robmacl/ilemt_cal_hw/stage/Pics/driver_label.jpg

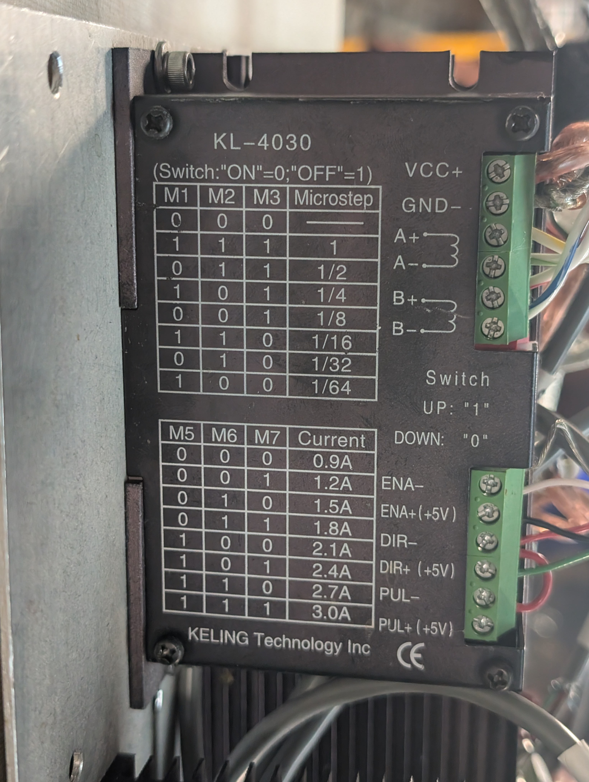
stage/Pics/driver_label.jpg
