robmacl/ilemt_cal_hw/stage/Pics/driver_switch_settings.jpg

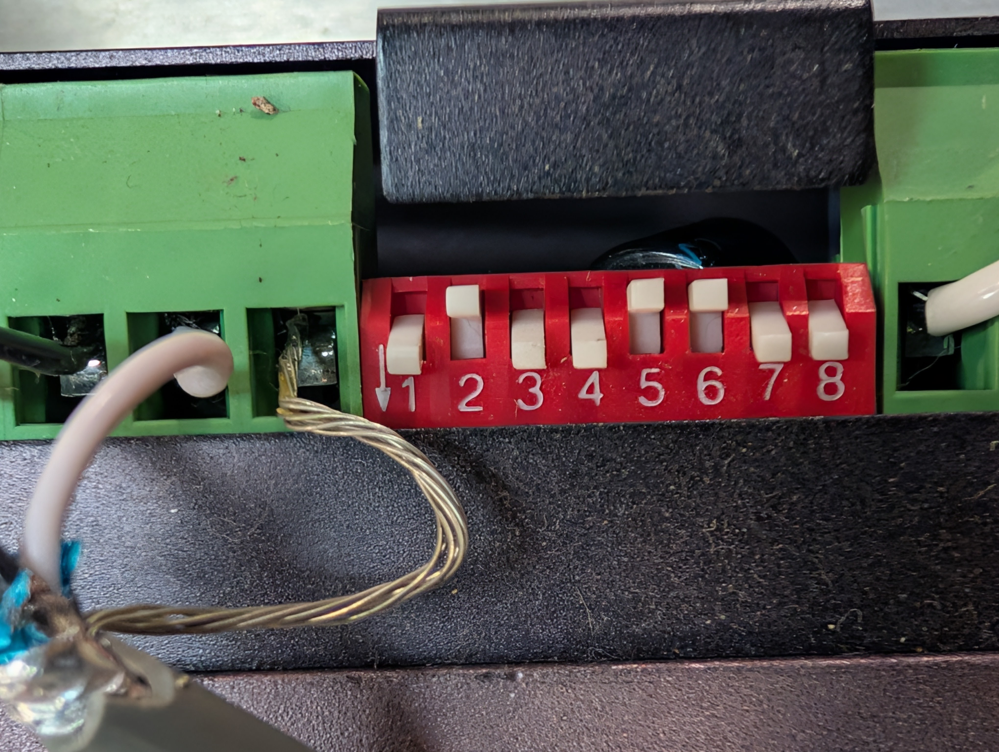
stage/Pics/driver_switch_settings.jpg
