robmacl/ilemt_cal_hw/stage/Pics/MC508_cable_id.jpg

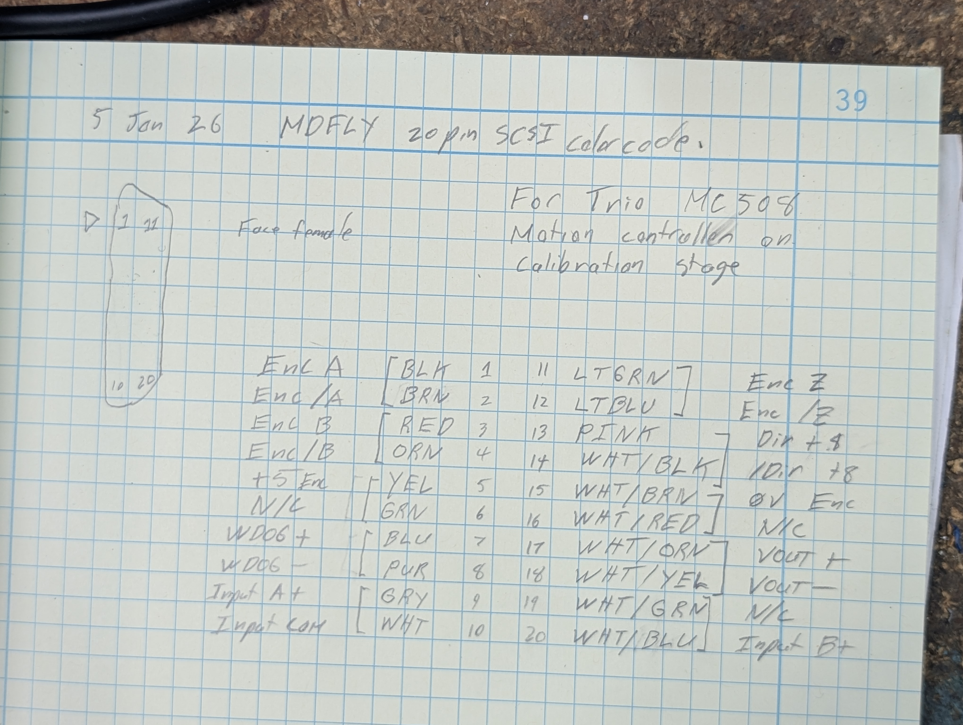
stage/Pics/MC508_cable_id.jpg
