robmacl/ilemt_cal_hw/stage/Pics/NI_UMI-77774_connector_side.jpg

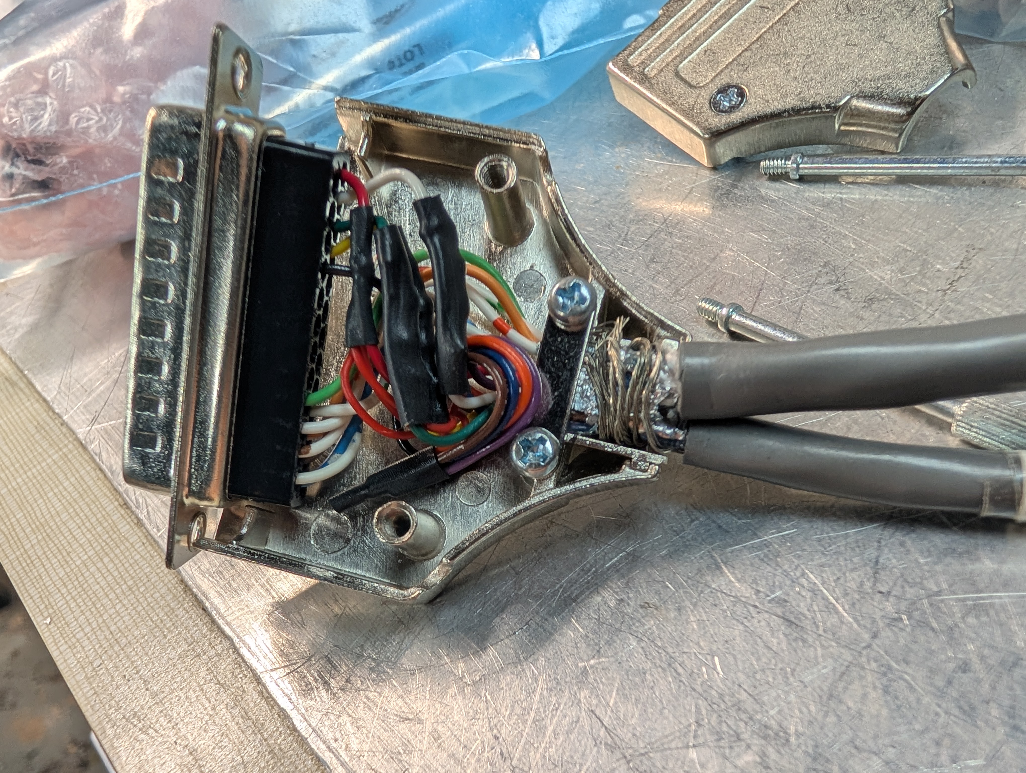
stage/Pics/NI_UMI-77774_connector_side.jpg
