robmacl/ilemt_cal_hw/stage/TrioDocumentation/MotionPerfect/AlarmSupport_files/image004.png

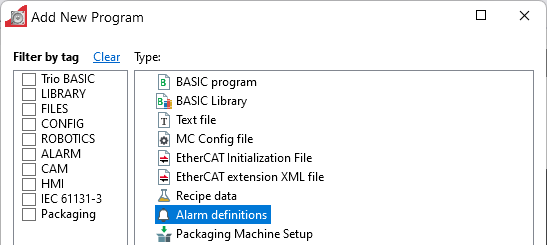
stage/TrioDocumentation/MotionPerfect/AlarmSupport_files/image004.png
