robmacl/ilemt_cal_hw/stage/TrioDocumentation/MotionPerfect/AlarmSupport_files/image006.png

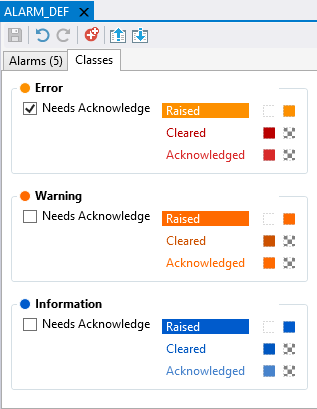
stage/TrioDocumentation/MotionPerfect/AlarmSupport_files/image006.png
