robmacl/ilemt_cal_hw/stage/TrioDocumentation/MotionPerfect/AnalogueIOViewer_files/image003.png

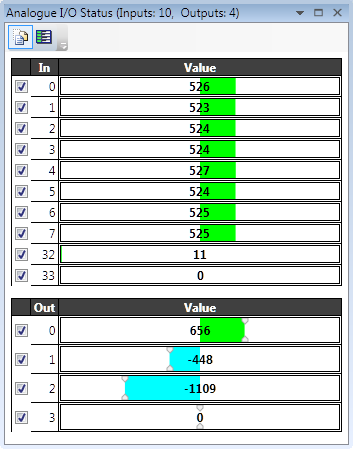
stage/TrioDocumentation/MotionPerfect/AnalogueIOViewer_files/image003.png
