robmacl/ilemt_cal_hw/stage/TrioDocumentation/MotionPerfect/APISymbols_files/image002.png

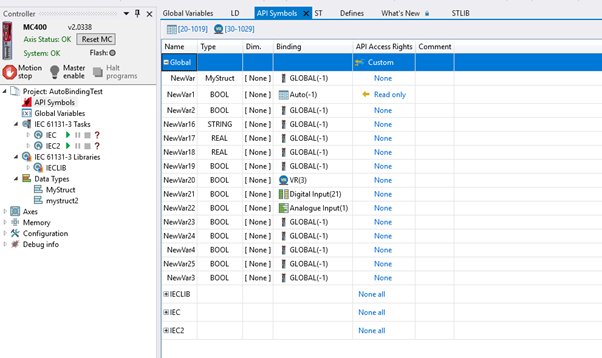
stage/TrioDocumentation/MotionPerfect/APISymbols_files/image002.png
