robmacl/ilemt_cal_hw/stage/TrioDocumentation/MotionPerfect/AutoBindings_files/image004.png

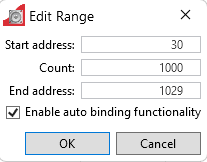
stage/TrioDocumentation/MotionPerfect/AutoBindings_files/image004.png
