robmacl/ilemt_cal_hw/stage/TrioDocumentation/MotionPerfect/AxisParameters_files/image009.jpg

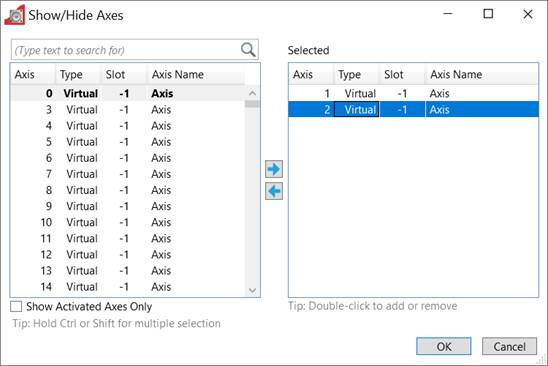
stage/TrioDocumentation/MotionPerfect/AxisParameters_files/image009.jpg
