robmacl/ilemt_cal_hw/stage/TrioDocumentation/MotionPerfect/ConnectionDialog_files/image008.png

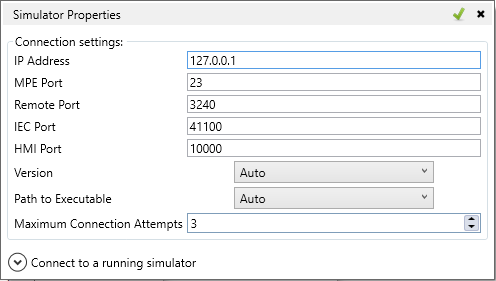
stage/TrioDocumentation/MotionPerfect/ConnectionDialog_files/image008.png
