robmacl/ilemt_cal_hw/stage/TrioDocumentation/MotionPerfect/DateAndTime_files/image002.png

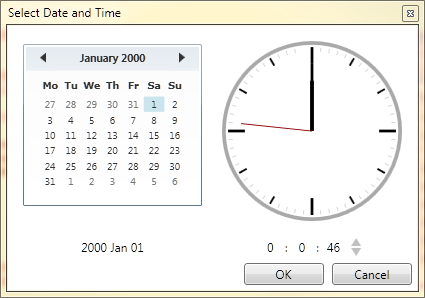
stage/TrioDocumentation/MotionPerfect/DateAndTime_files/image002.png
