robmacl/ilemt_cal_hw/stage/TrioDocumentation/MotionPerfect/DigitalIOViewer_files/image001.png

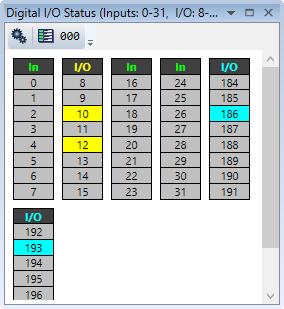
stage/TrioDocumentation/MotionPerfect/DigitalIOViewer_files/image001.png
