robmacl/ilemt_cal_hw/stage/TrioDocumentation/MotionPerfect/DigitalIOViewer_files/image004.png

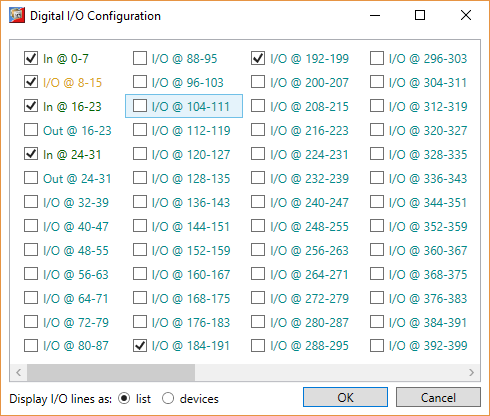
stage/TrioDocumentation/MotionPerfect/DigitalIOViewer_files/image004.png
