robmacl/ilemt_cal_hw/stage/TrioDocumentation/MotionPerfect/EtherCAT-Device-CoEObjects_files/image004.png

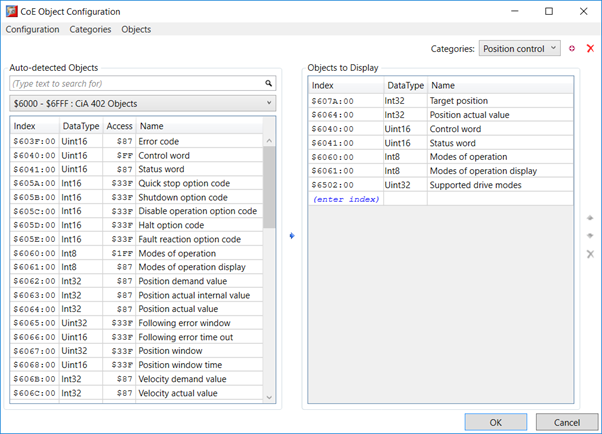
stage/TrioDocumentation/MotionPerfect/EtherCAT-Device-CoEObjects_files/image004.png
