robmacl/ilemt_cal_hw/stage/TrioDocumentation/MotionPerfect/EtherCAT-Device-FirmwareUpgrade_files/image003.png

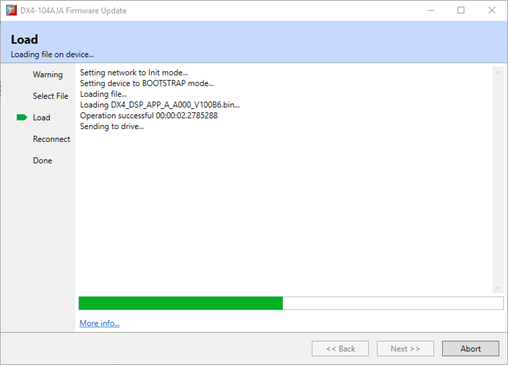
stage/TrioDocumentation/MotionPerfect/EtherCAT-Device-FirmwareUpgrade_files/image003.png
