robmacl/ilemt_cal_hw/stage/TrioDocumentation/MotionPerfect/EtherCAT-Device-Info_files/image001.png

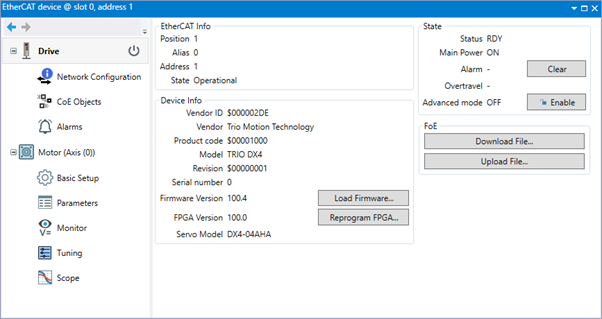
stage/TrioDocumentation/MotionPerfect/EtherCAT-Device-Info_files/image001.png
