robmacl/ilemt_cal_hw/stage/TrioDocumentation/MotionPerfect/EtherCAT-Diagnostics_files/image006.jpg

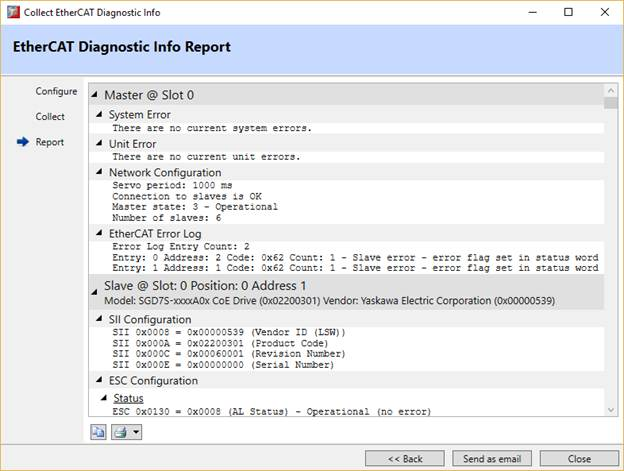
stage/TrioDocumentation/MotionPerfect/EtherCAT-Diagnostics_files/image006.jpg
