robmacl/ilemt_cal_hw/stage/TrioDocumentation/MotionPerfect/EtherCAT-Drive-Jog_files/image005.png

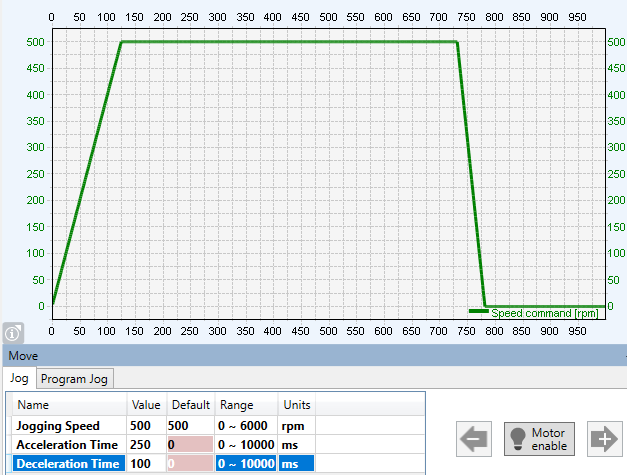
stage/TrioDocumentation/MotionPerfect/EtherCAT-Drive-Jog_files/image005.png
