robmacl/ilemt_cal_hw/stage/TrioDocumentation/MotionPerfect/EtherCAT-Drive-Parameters_files/image014.png

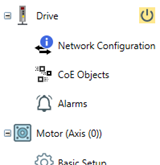
stage/TrioDocumentation/MotionPerfect/EtherCAT-Drive-Parameters_files/image014.png
