robmacl/ilemt_cal_hw/stage/TrioDocumentation/MotionPerfect/EtherCAT-Drive-Scope_files/image011.png

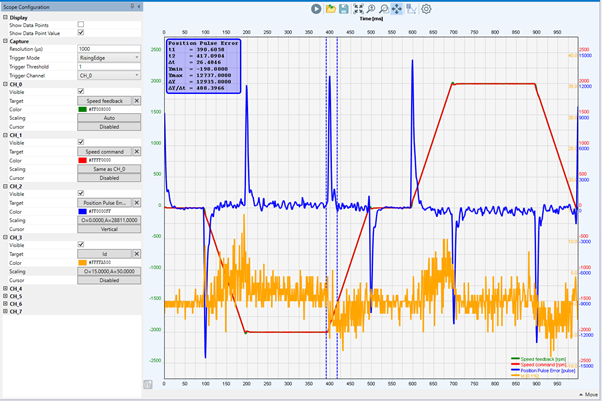
stage/TrioDocumentation/MotionPerfect/EtherCAT-Drive-Scope_files/image011.png
