robmacl/ilemt_cal_hw/stage/TrioDocumentation/MotionPerfect/EtherCAT-EC_EXTEND-Editor_files/image046.png

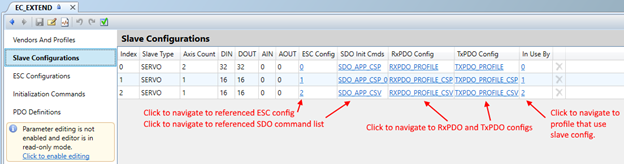
stage/TrioDocumentation/MotionPerfect/EtherCAT-EC_EXTEND-Editor_files/image046.png
