robmacl/ilemt_cal_hw/stage/TrioDocumentation/MotionPerfect/EtherCAT-ESI-Import_files/image011.jpg

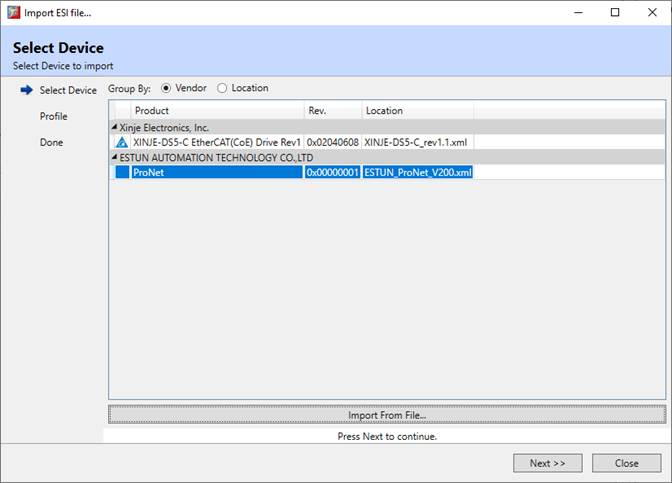
stage/TrioDocumentation/MotionPerfect/EtherCAT-ESI-Import_files/image011.jpg
