robmacl/ilemt_cal_hw/stage/TrioDocumentation/MotionPerfect/EtherCAT-ESI-Import_files/image020.jpg

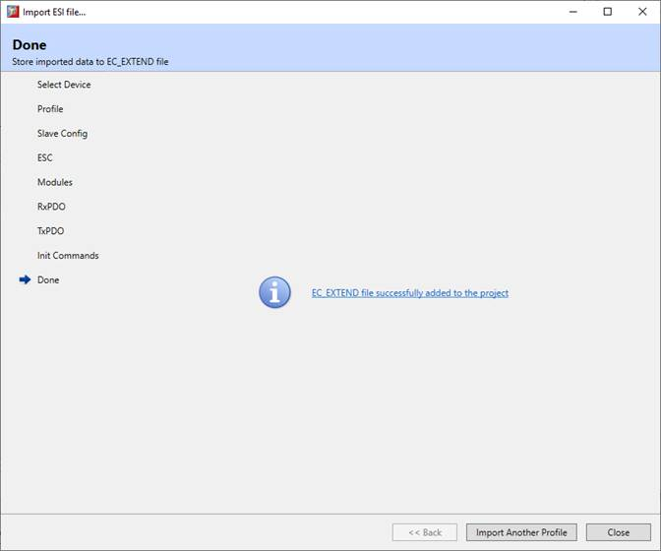
stage/TrioDocumentation/MotionPerfect/EtherCAT-ESI-Import_files/image020.jpg
