robmacl/ilemt_cal_hw/stage/TrioDocumentation/MotionPerfect/GlobalVariables_files/image001.png

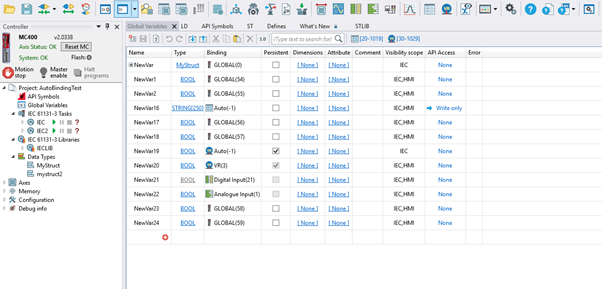
stage/TrioDocumentation/MotionPerfect/GlobalVariables_files/image001.png
