robmacl/ilemt_cal_hw/stage/TrioDocumentation/MotionPerfect/GoTo_files/image001.png

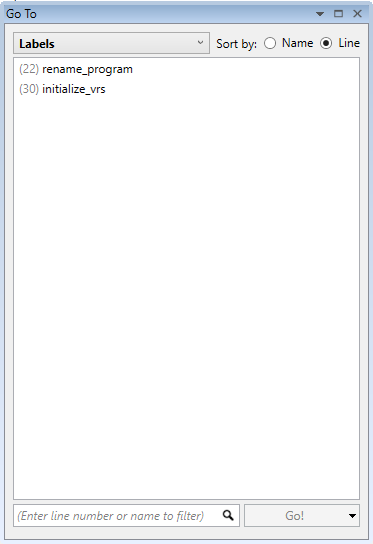
stage/TrioDocumentation/MotionPerfect/GoTo_files/image001.png
