robmacl/ilemt_cal_hw/stage/TrioDocumentation/MotionPerfect/ImportExportValues_files/image001.png

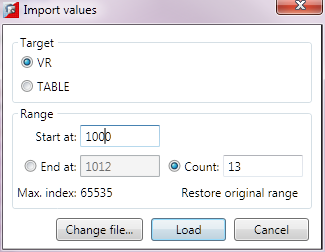
stage/TrioDocumentation/MotionPerfect/ImportExportValues_files/image001.png
