robmacl/ilemt_cal_hw/stage/TrioDocumentation/MotionPerfect/ImportExportValues_files/image002.png

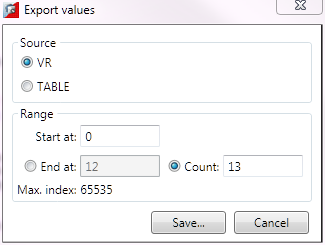
stage/TrioDocumentation/MotionPerfect/ImportExportValues_files/image002.png
