robmacl/ilemt_cal_hw/stage/TrioDocumentation/MotionPerfect/InitialConnection_files/image003.png

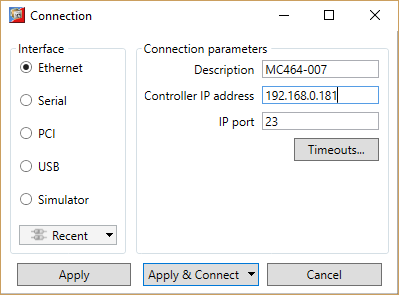
stage/TrioDocumentation/MotionPerfect/InitialConnection_files/image003.png
