robmacl/ilemt_cal_hw/stage/TrioDocumentation/MotionPerfect/LoadSystem_files/image005.png

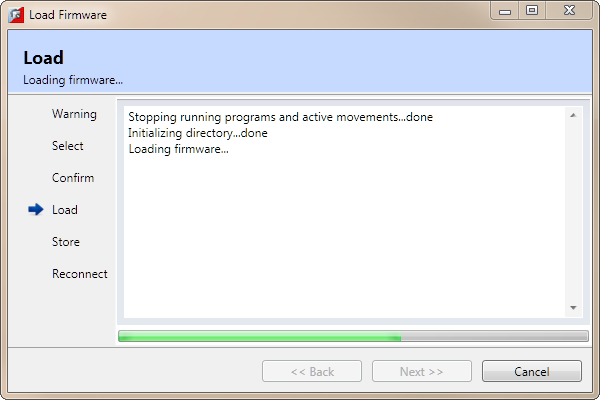
stage/TrioDocumentation/MotionPerfect/LoadSystem_files/image005.png
