robmacl/ilemt_cal_hw/stage/TrioDocumentation/MotionPerfect/LoadSystem_files/image006.png

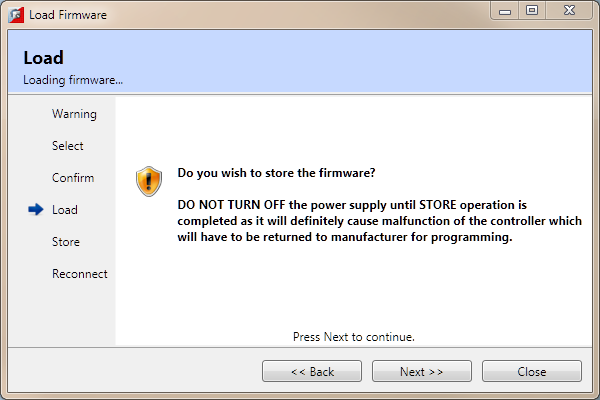
stage/TrioDocumentation/MotionPerfect/LoadSystem_files/image006.png
