robmacl/ilemt_cal_hw/stage/TrioDocumentation/MotionPerfect/MainWindow_files/image003.jpg

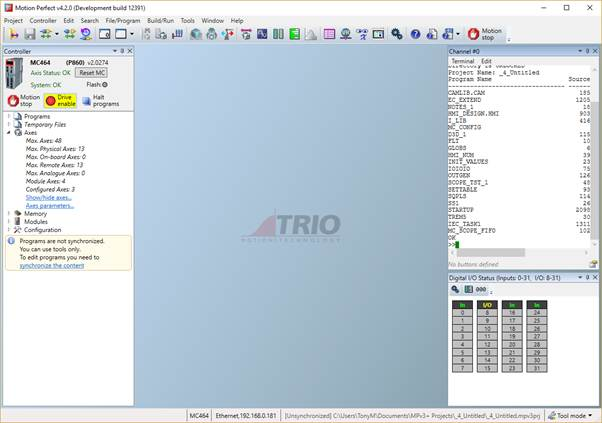
stage/TrioDocumentation/MotionPerfect/MainWindow_files/image003.jpg
