robmacl/ilemt_cal_hw/stage/TrioDocumentation/MotionPerfect/MemoryCardManager_files/image002.png

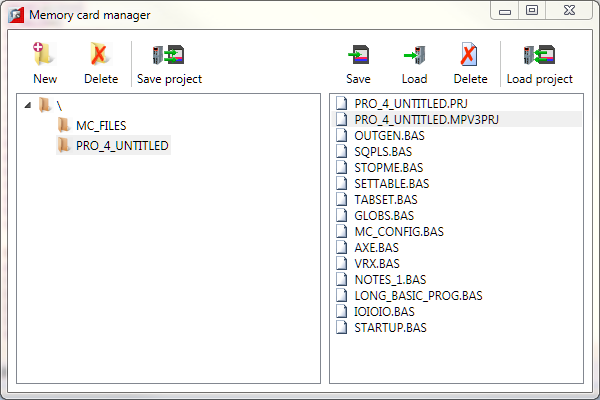
stage/TrioDocumentation/MotionPerfect/MemoryCardManager_files/image002.png
