robmacl/ilemt_cal_hw/stage/TrioDocumentation/MotionPerfect/ModifySTARTUP_files/image009.png

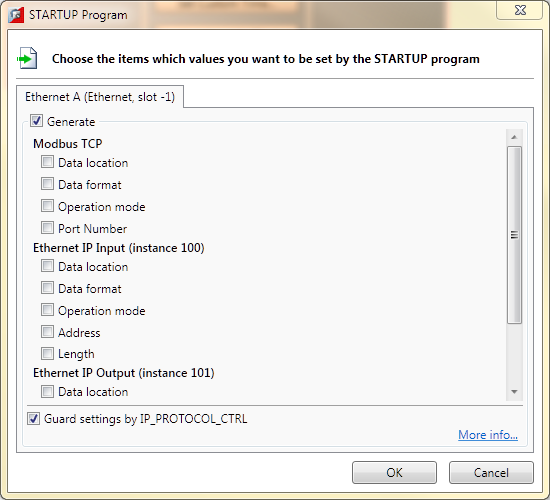
stage/TrioDocumentation/MotionPerfect/ModifySTARTUP_files/image009.png
