robmacl/ilemt_cal_hw/stage/TrioDocumentation/MotionPerfect/Options_Diagnostics_files/image001.jpg

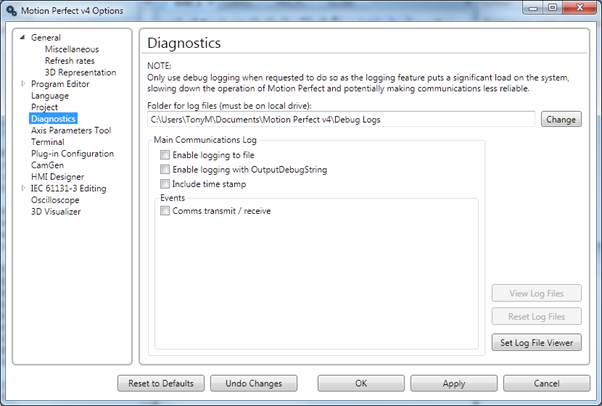
stage/TrioDocumentation/MotionPerfect/Options_Diagnostics_files/image001.jpg
