robmacl/ilemt_cal_hw/stage/TrioDocumentation/MotionPerfect/Options_HMI_Designer-FontsAndColours_files/image001.jpg

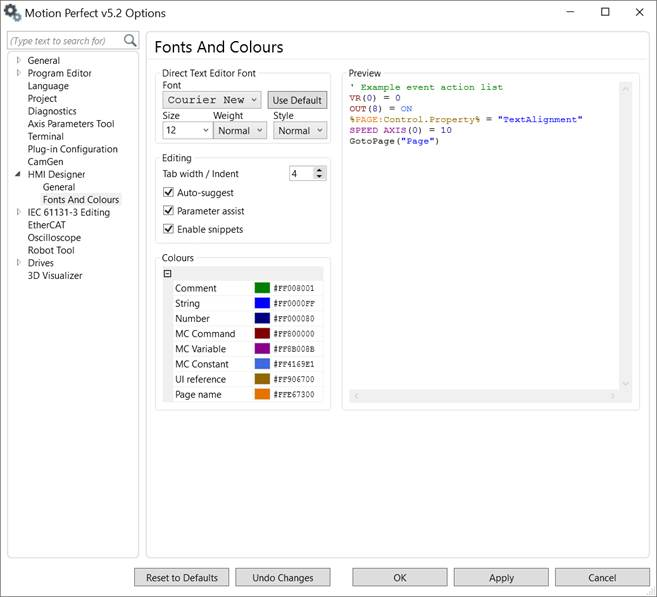
stage/TrioDocumentation/MotionPerfect/Options_HMI_Designer-FontsAndColours_files/image001.jpg
