robmacl/ilemt_cal_hw/stage/TrioDocumentation/MotionPerfect/Options_IEC61131-General_files/image001.jpg

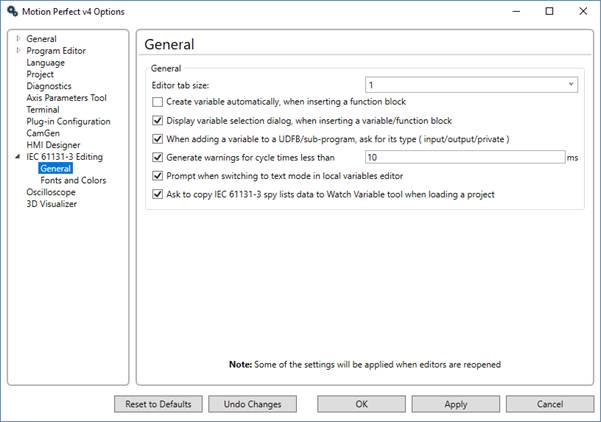
stage/TrioDocumentation/MotionPerfect/Options_IEC61131-General_files/image001.jpg
