robmacl/ilemt_cal_hw/stage/TrioDocumentation/MotionPerfect/Options_Oscilloscope_files/image002.png

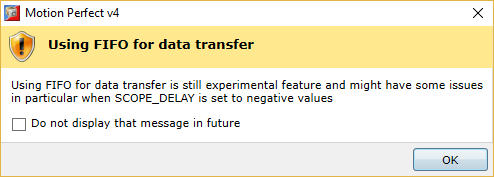
stage/TrioDocumentation/MotionPerfect/Options_Oscilloscope_files/image002.png
