robmacl/ilemt_cal_hw/stage/TrioDocumentation/MotionPerfect/Oscilloscope_files/image001.png

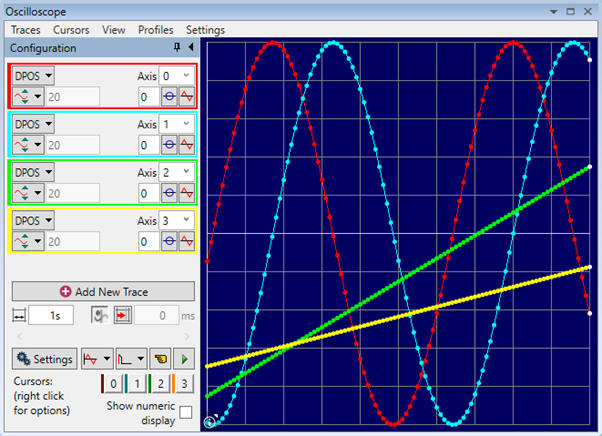
stage/TrioDocumentation/MotionPerfect/Oscilloscope_files/image001.png
