robmacl/ilemt_cal_hw/stage/TrioDocumentation/MotionPerfect/Oscilloscope_HorizontalControls_files/image027.png

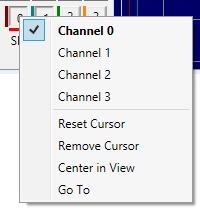
stage/TrioDocumentation/MotionPerfect/Oscilloscope_HorizontalControls_files/image027.png
