robmacl/ilemt_cal_hw/stage/TrioDocumentation/MotionPerfect/Oscilloscope_Settings_files/image003.jpg

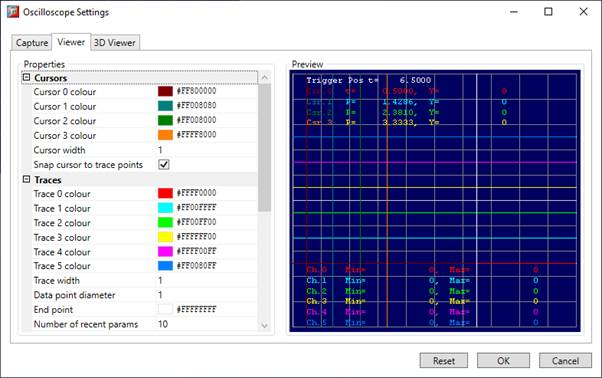
stage/TrioDocumentation/MotionPerfect/Oscilloscope_Settings_files/image003.jpg
