robmacl/ilemt_cal_hw/stage/TrioDocumentation/MotionPerfect/Oscilloscope_ViewModes_files/image004.png

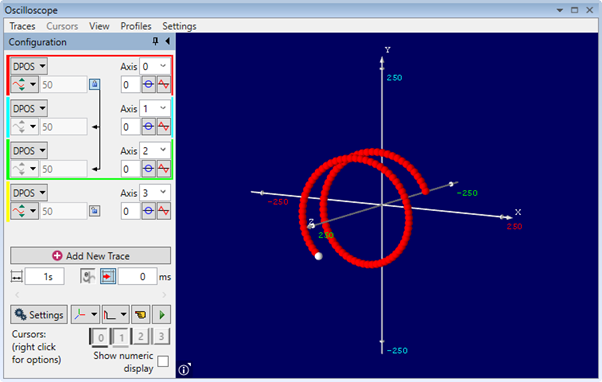
stage/TrioDocumentation/MotionPerfect/Oscilloscope_ViewModes_files/image004.png
