robmacl/ilemt_cal_hw/stage/TrioDocumentation/MotionPerfect/Package_AuthoringExample_files/image004.jpg

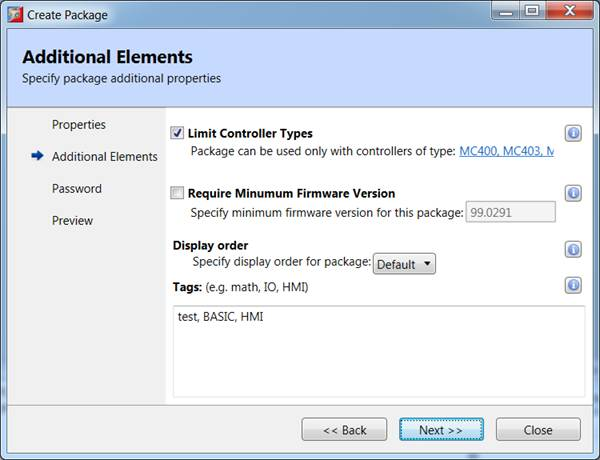
stage/TrioDocumentation/MotionPerfect/Package_AuthoringExample_files/image004.jpg
