robmacl/ilemt_cal_hw/stage/TrioDocumentation/MotionPerfect/Package_AuthoringExample_files/image005.jpg

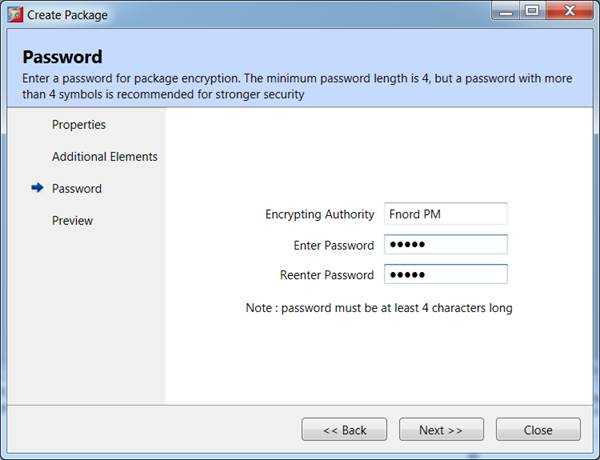
stage/TrioDocumentation/MotionPerfect/Package_AuthoringExample_files/image005.jpg
