robmacl/ilemt_cal_hw/stage/TrioDocumentation/MotionPerfect/Package_Update_files/image004.png

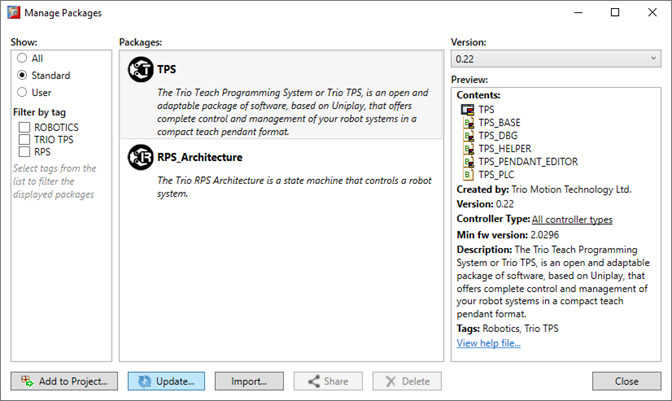
stage/TrioDocumentation/MotionPerfect/Package_Update_files/image004.png
