robmacl/ilemt_cal_hw/stage/TrioDocumentation/MotionPerfect/ProjectCheck_files/image010.png

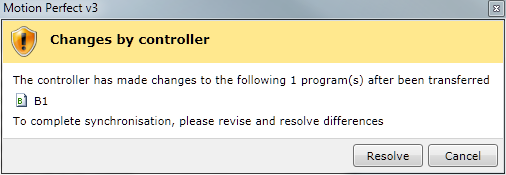
stage/TrioDocumentation/MotionPerfect/ProjectCheck_files/image010.png
