robmacl/ilemt_cal_hw/stage/TrioDocumentation/MotionPerfect/ProjectEncryption-EncryptProject_files/image001.jpg

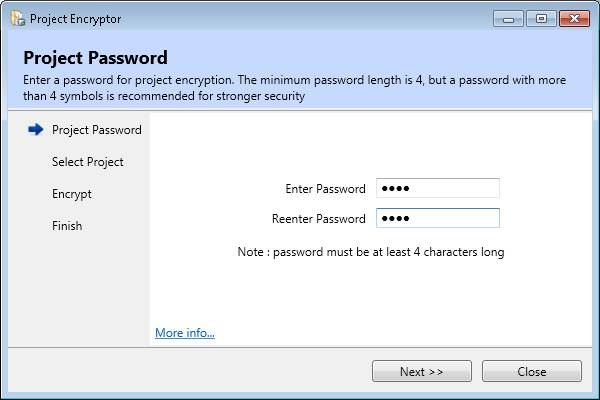
stage/TrioDocumentation/MotionPerfect/ProjectEncryption-EncryptProject_files/image001.jpg
