robmacl/ilemt_cal_hw/stage/TrioDocumentation/MotionPerfect/ProjectItemGroups_files/image002.png

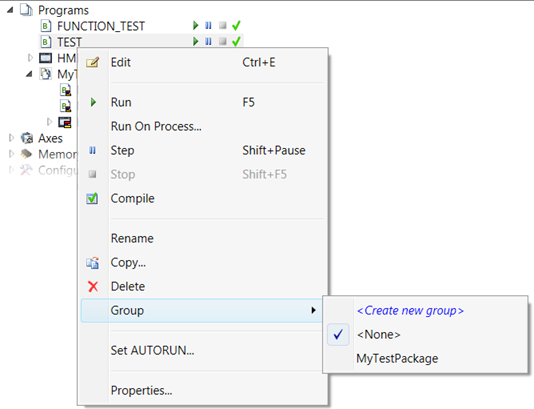
stage/TrioDocumentation/MotionPerfect/ProjectItemGroups_files/image002.png
