robmacl/ilemt_cal_hw/stage/TrioDocumentation/MotionPerfect/ProjectTemplate_Creation_files/image003.jpg

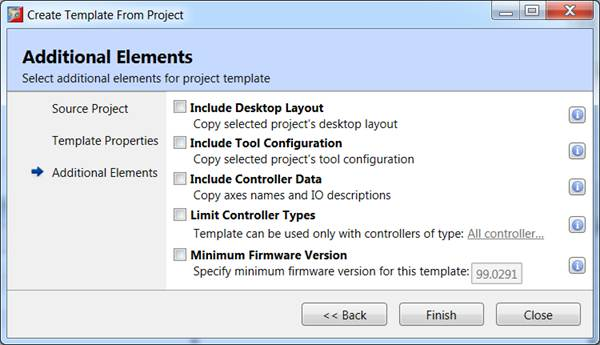
stage/TrioDocumentation/MotionPerfect/ProjectTemplate_Creation_files/image003.jpg
