robmacl/ilemt_cal_hw/stage/TrioDocumentation/MotionPerfect/ProjectTemplate_Updates_files/image002.png

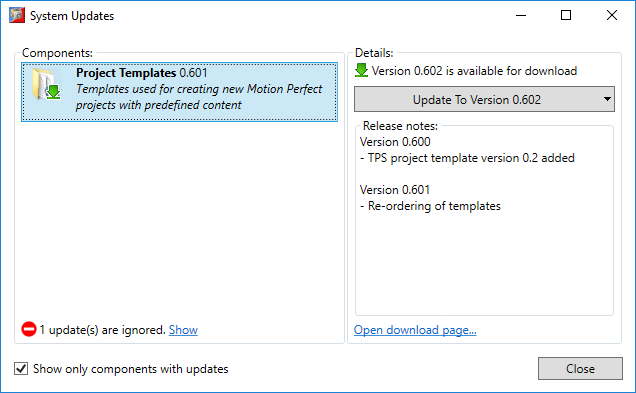
stage/TrioDocumentation/MotionPerfect/ProjectTemplate_Updates_files/image002.png
