robmacl/ilemt_cal_hw/stage/TrioDocumentation/MotionPerfect/RecipeSupport_files/image005.png

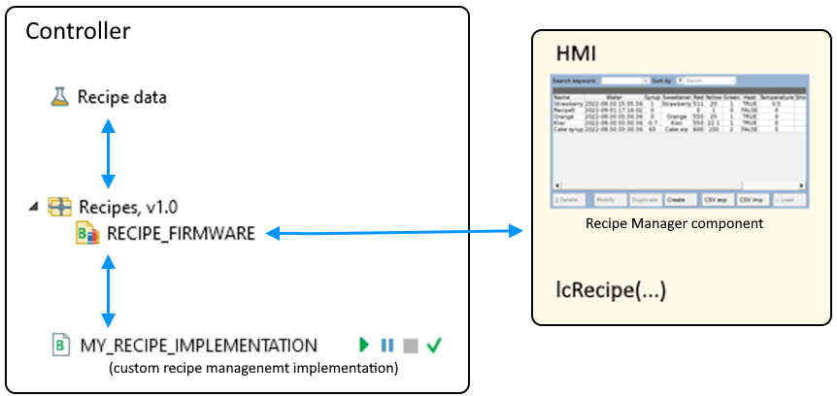
stage/TrioDocumentation/MotionPerfect/RecipeSupport_files/image005.png
