robmacl/ilemt_cal_hw/stage/TrioDocumentation/MotionPerfect/RecipeSupport_files/image007.png

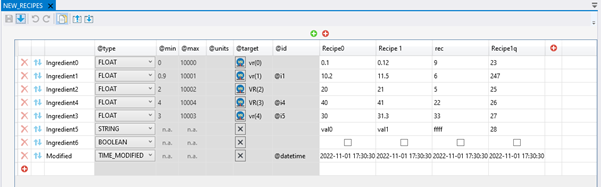
stage/TrioDocumentation/MotionPerfect/RecipeSupport_files/image007.png
