robmacl/ilemt_cal_hw/stage/TrioDocumentation/MotionPerfect/RobotDefinitions_files/image009.png

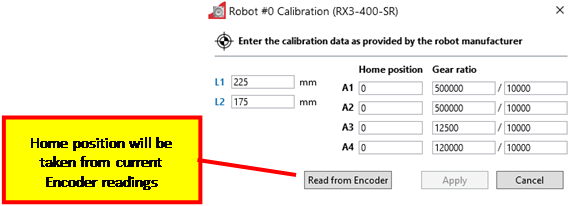
stage/TrioDocumentation/MotionPerfect/RobotDefinitions_files/image009.png
