robmacl/ilemt_cal_hw/stage/TrioDocumentation/MotionPerfect/RobotTool_CollisionObject_files/image001.png

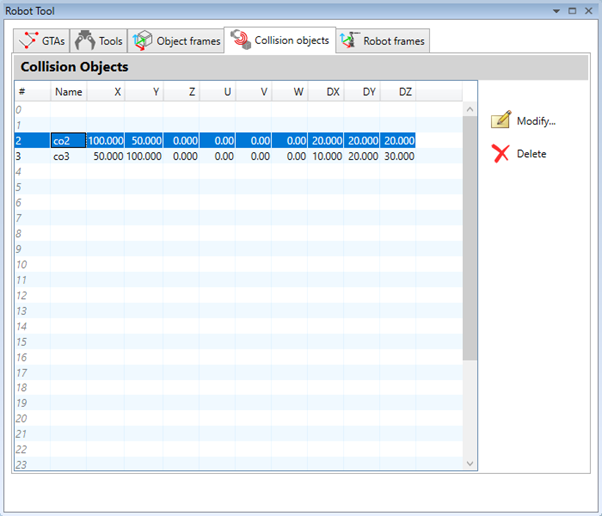
stage/TrioDocumentation/MotionPerfect/RobotTool_CollisionObject_files/image001.png
