robmacl/ilemt_cal_hw/stage/TrioDocumentation/MotionPerfect/RobotTool_GTA_files/image005.png

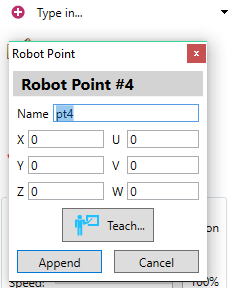
stage/TrioDocumentation/MotionPerfect/RobotTool_GTA_files/image005.png
