robmacl/ilemt_cal_hw/stage/TrioDocumentation/MotionPerfect/RobotTool_ObjectFrame_files/image005.png

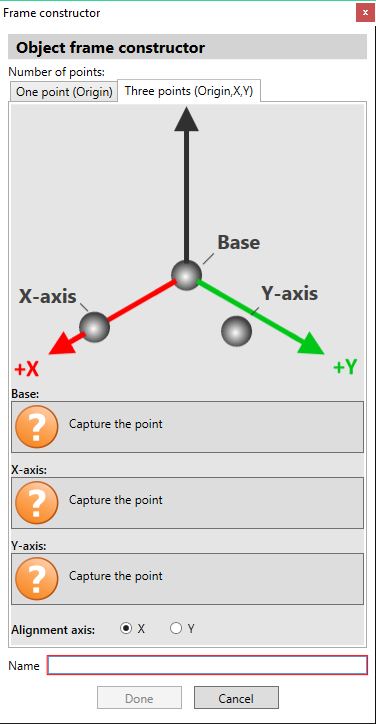
stage/TrioDocumentation/MotionPerfect/RobotTool_ObjectFrame_files/image005.png
