robmacl/ilemt_cal_hw/stage/TrioDocumentation/MotionPerfect/RobotTool_RobotFrame_files/image001.png

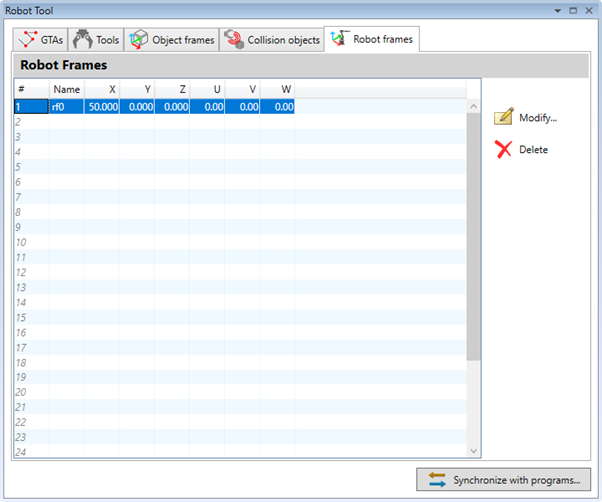
stage/TrioDocumentation/MotionPerfect/RobotTool_RobotFrame_files/image001.png
