robmacl/ilemt_cal_hw/stage/TrioDocumentation/MotionPerfect/RobotTool_ToolOffset_files/image006.png

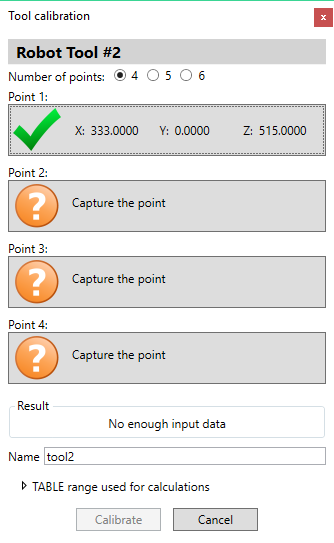
stage/TrioDocumentation/MotionPerfect/RobotTool_ToolOffset_files/image006.png
