robmacl/ilemt_cal_hw/stage/TrioDocumentation/MotionPerfect/RTEX-Overview_files/image001.png

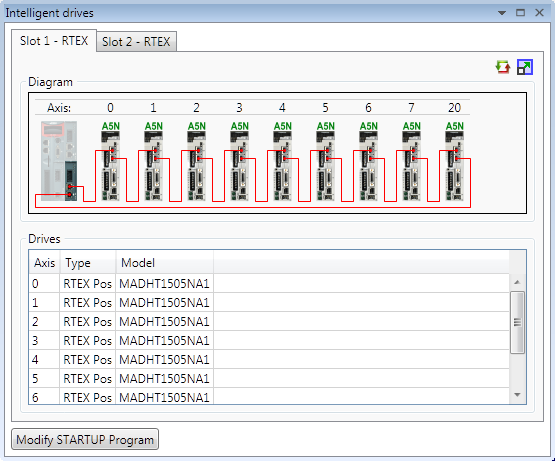
stage/TrioDocumentation/MotionPerfect/RTEX-Overview_files/image001.png
