robmacl/ilemt_cal_hw/stage/TrioDocumentation/MotionPerfect/RTEX-Overview_files/image006.png

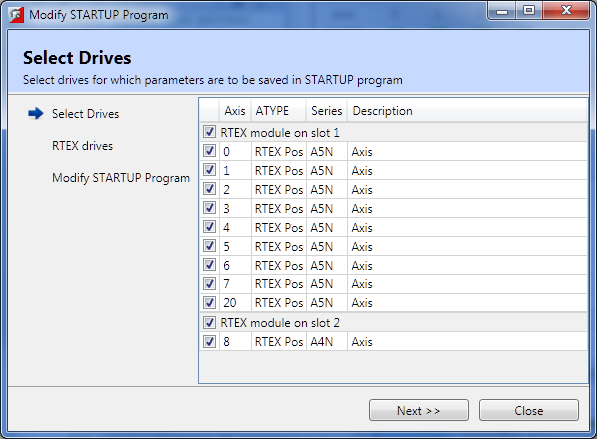
stage/TrioDocumentation/MotionPerfect/RTEX-Overview_files/image006.png
