robmacl/ilemt_cal_hw/stage/TrioDocumentation/MotionPerfect/RTEX-Overview_files/image007.png

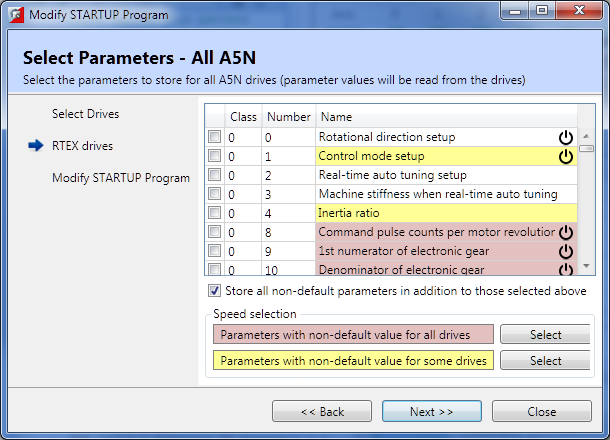
stage/TrioDocumentation/MotionPerfect/RTEX-Overview_files/image007.png
