robmacl/ilemt_cal_hw/stage/TrioDocumentation/MotionPerfect/RTEX-Overview_files/image011.jpg

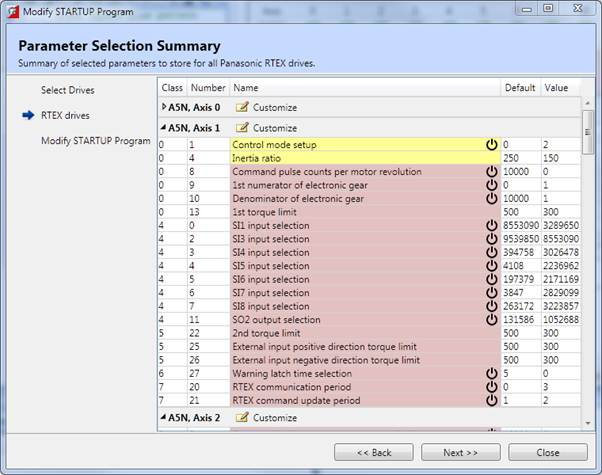
stage/TrioDocumentation/MotionPerfect/RTEX-Overview_files/image011.jpg
