robmacl/ilemt_cal_hw/stage/TrioDocumentation/MotionPerfect/RTEX-Overview_files/image012.jpg

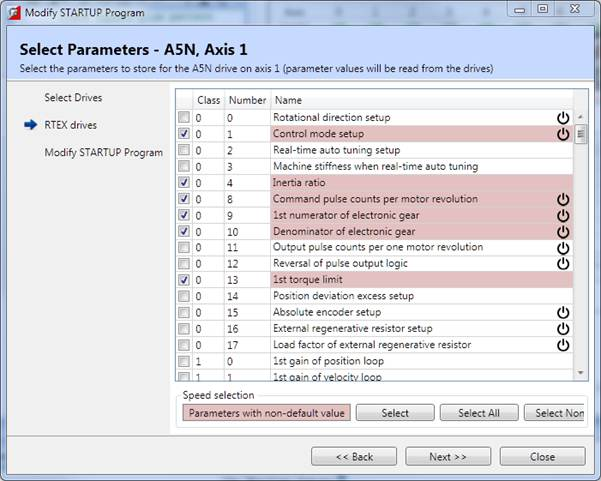
stage/TrioDocumentation/MotionPerfect/RTEX-Overview_files/image012.jpg
