robmacl/ilemt_cal_hw/stage/TrioDocumentation/MotionPerfect/RTEX-Overview_files/image013.jpg

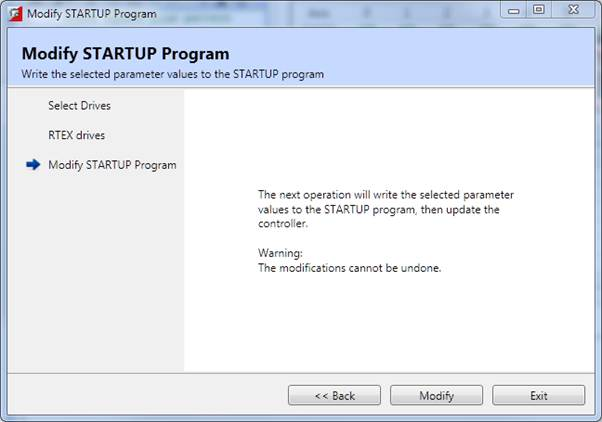
stage/TrioDocumentation/MotionPerfect/RTEX-Overview_files/image013.jpg
