robmacl/ilemt_cal_hw/stage/TrioDocumentation/MotionPerfect/SharedProjectDevelopment_files/image001.png

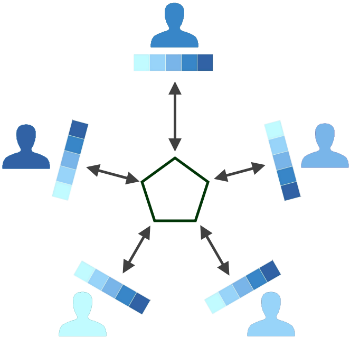
stage/TrioDocumentation/MotionPerfect/SharedProjectDevelopment_files/image001.png
