robmacl/ilemt_cal_hw/stage/TrioDocumentation/MotionPerfect/TableViewer_files/image008.jpg

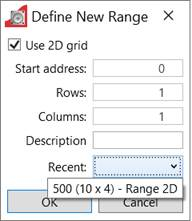
stage/TrioDocumentation/MotionPerfect/TableViewer_files/image008.jpg
