robmacl/ilemt_cal_hw/stage/TrioDocumentation/MotionPerfect/VRViewer_files/image004.jpg

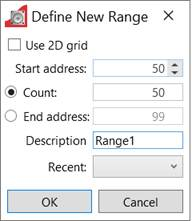
stage/TrioDocumentation/MotionPerfect/VRViewer_files/image004.jpg
