robmacl/ilemt_cal_hw/stage/wiring_stepper.bom.tsv

Id | Description | Qty | Unit | Designators
1 | Cable, 1 wires | 0 | m | ENA_N, ENA_P, GND_1, GND_2, GND_SCSI, STEP_DIR, STEP_PUL
2 | Connector, Front-panel enable bus, 2 pins | 1 |  | FP_ENABLE
3 | Connector, MDR-20, 3 pins | 1 |  | MC508_STEP
4 | Connector, Screw Terminal, 6 pins | 1 |  | DRV
5 | Connector, Splice | 1
