robmacl/ilemt_cal_hw/optical/sensor_mount.SLDASM

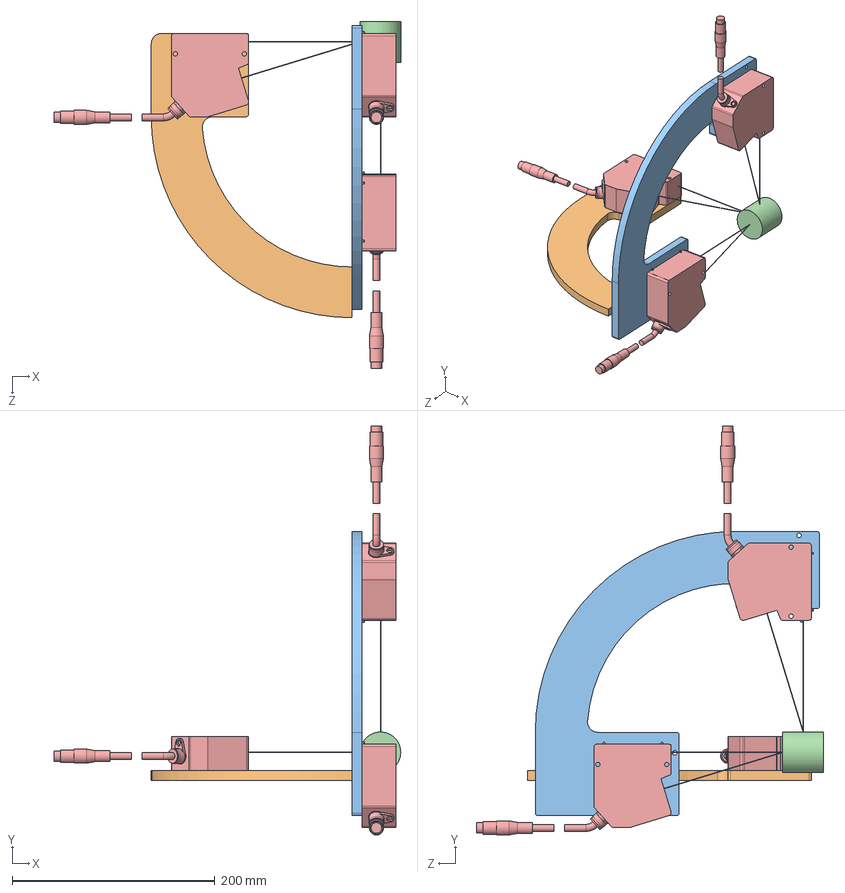
[picture p117: CAD file, 2026-01-27]
optical/sensor_mount.SLDASM
341.7 x 403.2 x 341.7 mm
LK-G150_152_155_157_2 x 3
cylinder_target
YZ_bracket
X_bracket
93600A208_316 Stainless Steel Dowel Pin x 6
