robmacl/ilemt_cal_hw/stage/mechanical/sensor_boom.SLDASM

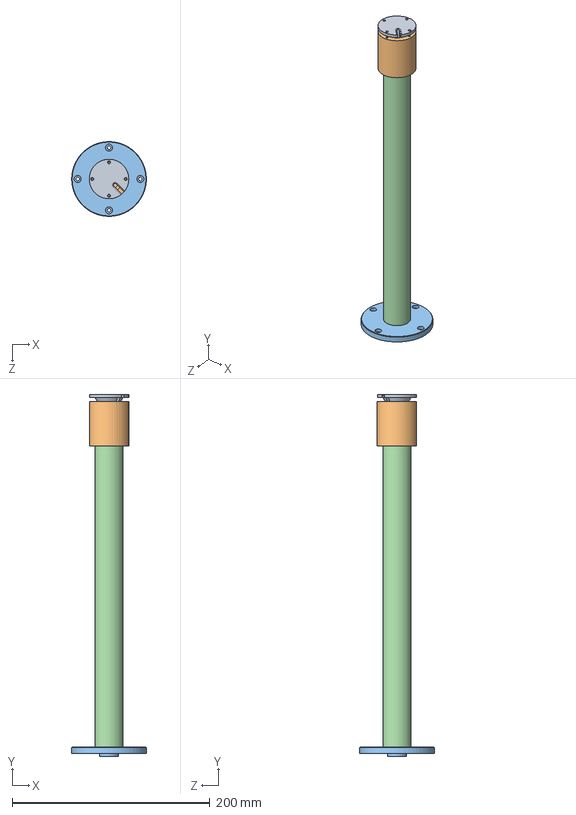
[picture p118: CAD file, 2026-05-16]
stage/mechanical/sensor_boom.SLDASM
75.6 x 366.4 x 75.7 mm
5287T681_High-Strength Lightweight Carbon Fiber Tube
boom_base
boom_end
sensor_holder
