robmacl/ilemt_cal_hw/stage/back_panel.SLDPRT

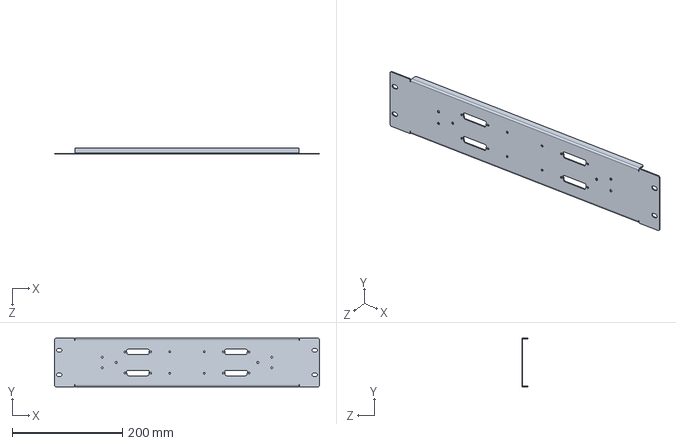
[picture p119: CAD file, 2026-02-22]
stage/back_panel.SLDPRT
480.0 x 88.2 x 11.8 mm
