robmacl/ilemt_cal_hw/stage/mechanical/sensor_holder.SLDPRT

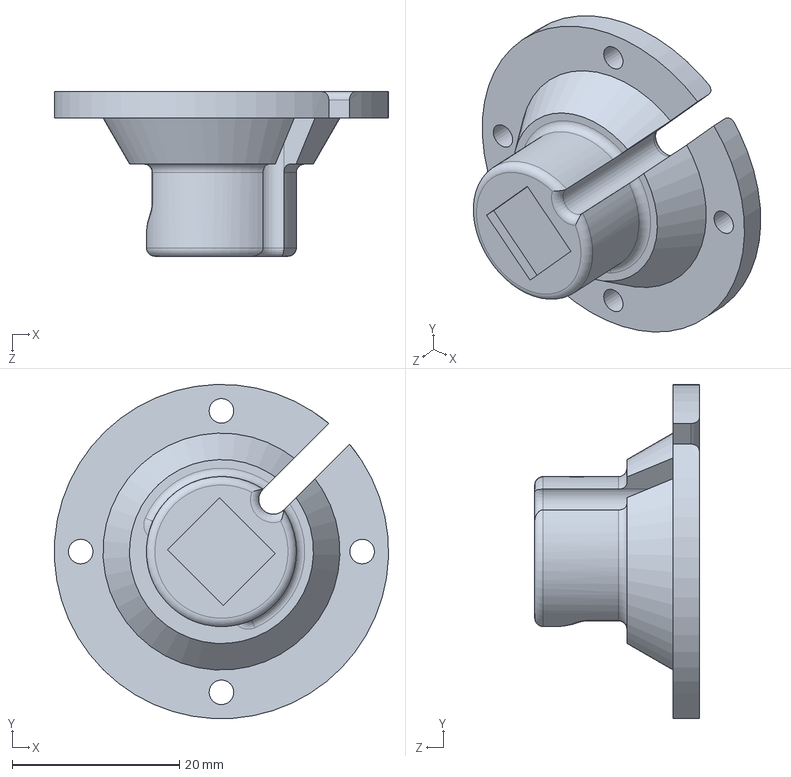
[picture p120: CAD file, 2026-09-29]
stage/mechanical/sensor_holder.SLDPRT
39.9 x 39.9 x 19.7 mm
