robmacl/ilemt_cal_hw/optical/components/LK-G150_152_155_157_2.sldprt

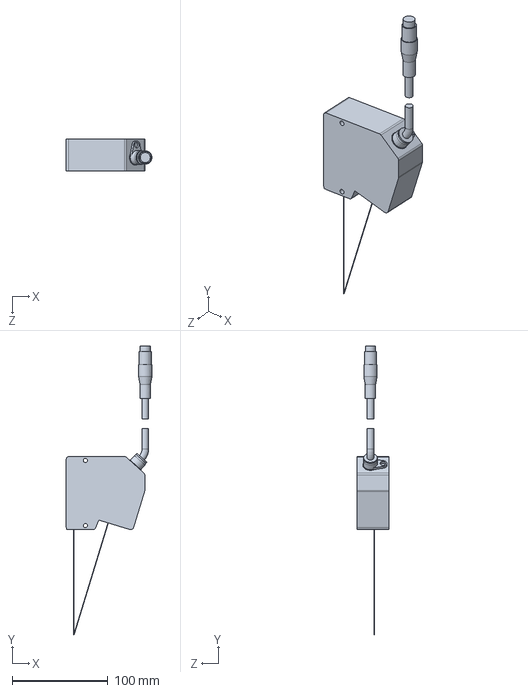
[picture p121: CAD file, 2026-01-27]
optical/components/LK-G150_152_155_157_2.sldprt
89.7 x 301.7 x 33.3 mm
