robmacl/ilemt_cal_hw/optical/YZ_bracket.SLDPRT

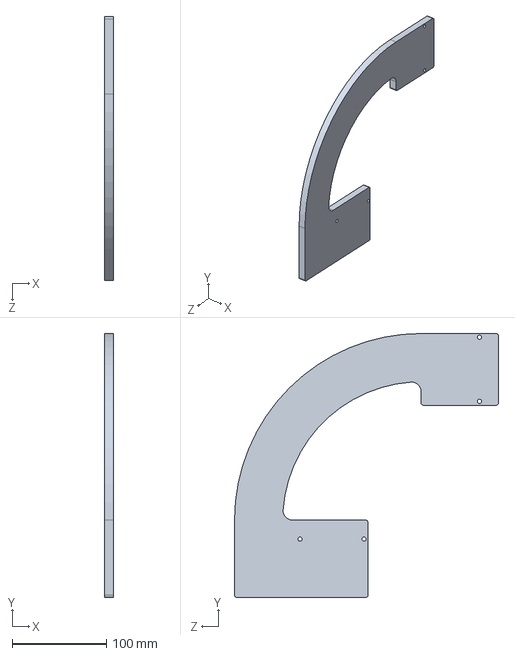
[picture p122: CAD file, 2026-01-27]
optical/YZ_bracket.SLDPRT
10.0 x 280.2 x 280.2 mm
