robmacl/ilemt_cal_hw/stage/mechanical/components/RT-3-10.SLDPRT

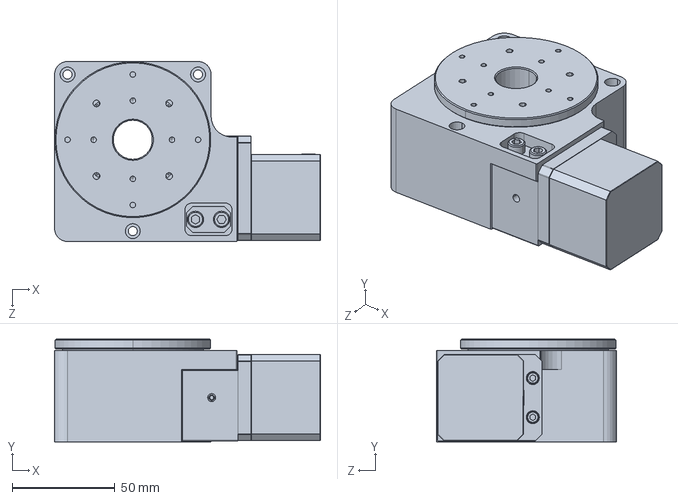
[picture p123: CAD file, 2026-05-16]
stage/mechanical/components/RT-3-10.SLDPRT
129.4 x 50.0 x 87.6 mm
