robmacl/ilemt_cal_hw/optical/cylinder_target.SLDPRT

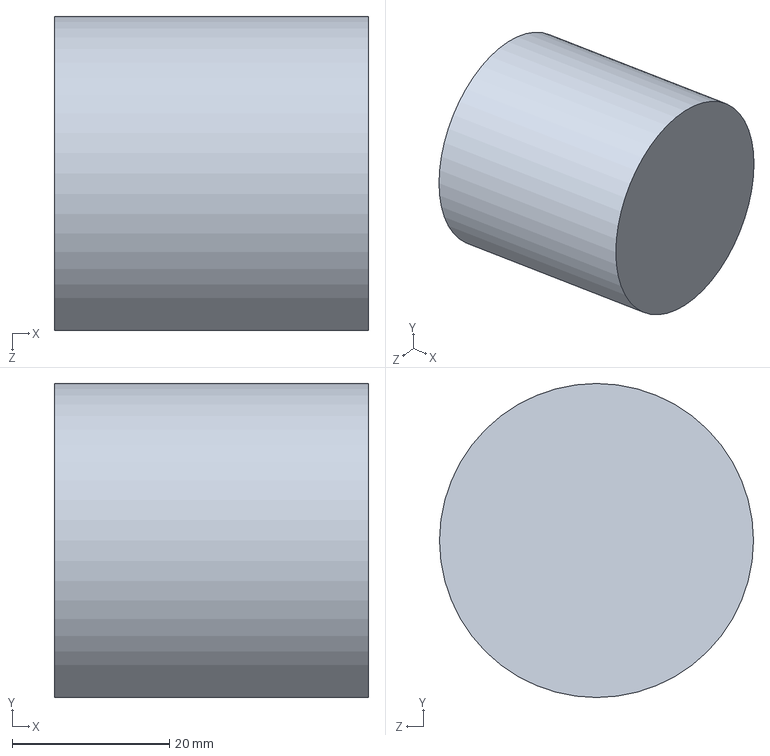
[picture p124: CAD file, 2026-01-27]
optical/cylinder_target.SLDPRT
40.0 x 40.0 x 40.0 mm
