robmacl/ilemt_cal_hw/stage/mechanical/boom_end.SLDPRT

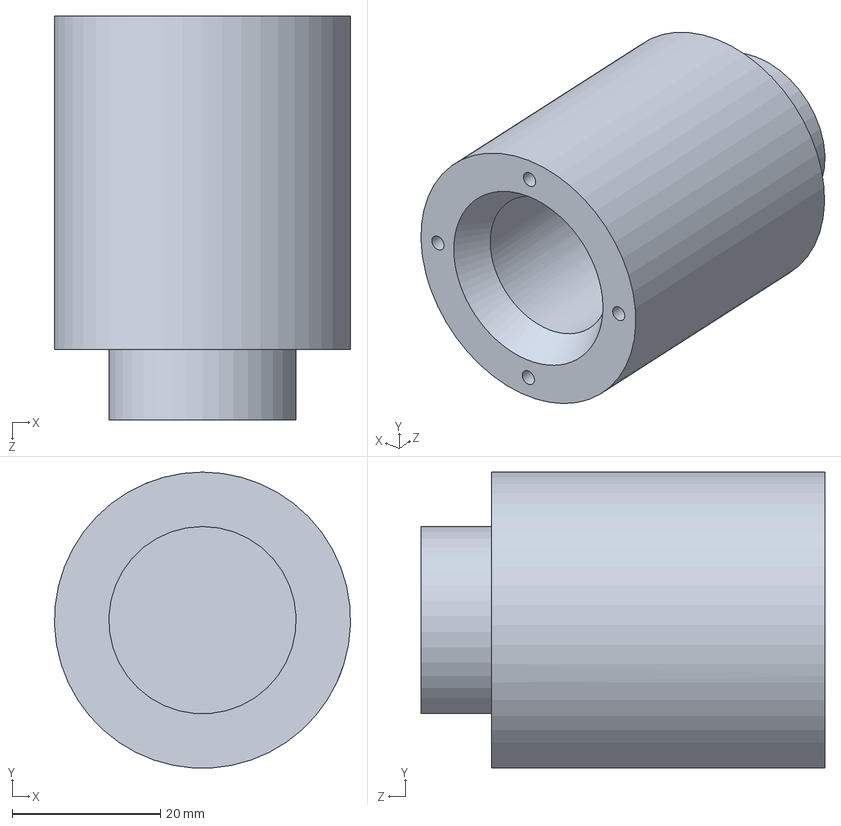
[picture p125: CAD file, 2026-05-16]
stage/mechanical/boom_end.SLDPRT
40.0 x 40.0 x 54.5 mm
