robmacl/ilemt_cal_hw/optical/X_bracket.SLDPRT

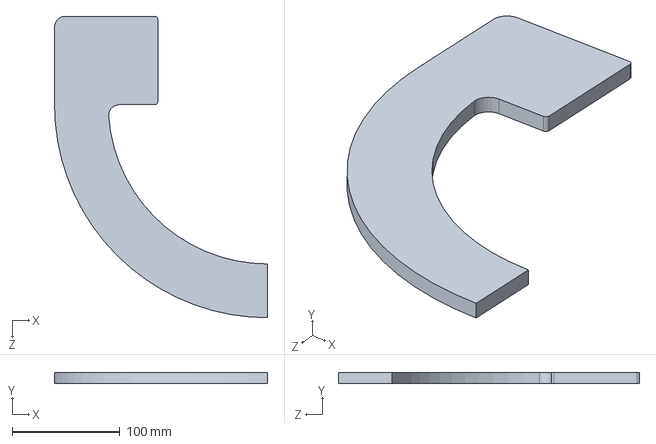
[picture p126: CAD file, 2026-01-27]
optical/X_bracket.SLDPRT
198.0 x 10.0 x 280.2 mm
