robmacl/ilemt_cal_hw/stage/mechanical/boom_base.SLDPRT

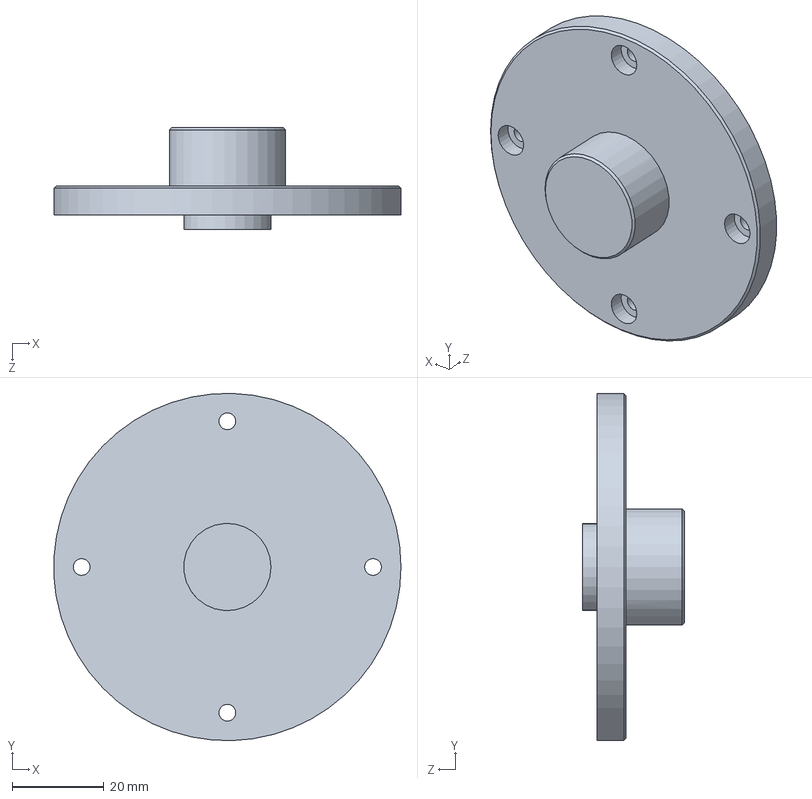
[picture p127: CAD file, 2026-05-16]
stage/mechanical/boom_base.SLDPRT
75.6 x 75.7 x 22.2 mm
