robmacl/ilemt_cal_hw/optical/components/93600A208_316 Stainless Steel Dowel Pin.SLDPRT

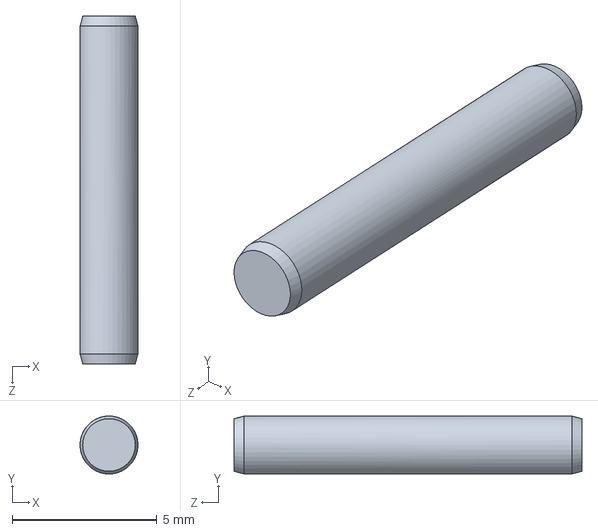
[picture p128: CAD file, 2026-01-27]
optical/components/93600A208_316 Stainless Steel Dowel Pin.SLDPRT
2.00 x 2.00 x 12.0 mm
