robmacl/ilemt_cal_hw/stage/mechanical/components/5287T681_High-Strength Lightweight Carbon Fiber Tube.SLDPRT

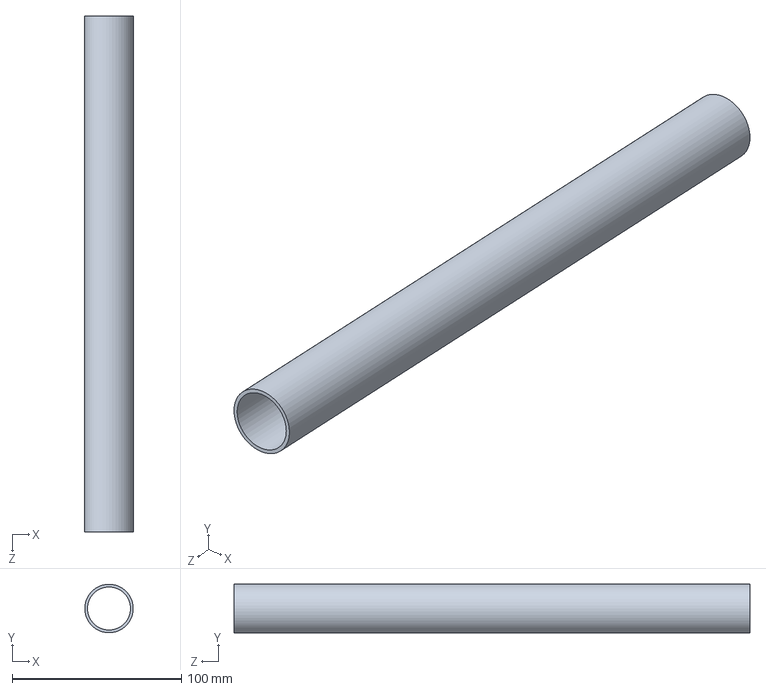
[picture p129: CAD file, 2026-05-16]
stage/mechanical/components/5287T681_High-Strength Lightweight Carbon Fiber Tube.SLDPRT
28.7 x 28.7 x 304.8 mm
