robmacl/ilemt_cal_hw/stage/stage_wiring.md

# Stage Wiring Documentation

This document is the definitive reference for the physical/electrical wiring.
Controller configuration (axis mapping, units, I/O, motion parameters, homing)
and MC508 quirks live in [Configuration.md](Configuration.md).

## Overview

This document tracks the wiring of the existing ILEMT calibration stage cables,
originally terminated for the NI UMI-7774 breakout interface, and their adaptation
to the Trio MC508 P849 motion controller.

## NI UMI-7774 Feedback Connector (DB-25 Female on UMI)

The stage cables plug into the per-axis **Feedback** connector on the UMI-7774.
This is a 25-pin D-SUB. The cable side is a DB-25 male connector.

### UMI-7774 Feedback Connector Pinout (from NI manual)

| Pin | Signal | Isolated | Notes |
|-----|---|---|---|
| 1 | Encoder Phase A | No | Differential + |
| 2 | Encoder Phase B | No | Differential + |
| 3 | Encoder Index | No | Differential + |
| 4 | +5V Output | No | Encoder power (shared 1A max)  |
| 5 | Reserved | No | |
| 6 | Reserved | No | |
| 7 | Reserved | No | |
| 8 | +5V Output | No | Encoder power (shared 1A max)  |
| 9 | NC | No | |
| 10  | Forward Limit | Yes | Optically isolated sinking input |
| 11  | Home Input | Yes | Optically isolated sinking input |
| 12  | Reverse Limit | Yes | Optically isolated sinking input |
| 13  | Viso (Output) | Yes | Power for isolated I/O (5-30V) |
| 14  | Encoder Phase A- | No | Differential - |
| 15  | Encoder Phase B- | No | Differential - |
| 16  | Encoder Index- | No | Differential - |
| 17  | Digital Ground | No | |
| 18  | Digital Ground | No | |
| 19  | Digital Ground | No | |
| 20  | Digital Ground | No | |
| 21  | NC | No | |
| 22  | Ciso | Yes | Isolated common |
| 23  | Ciso | Yes | Isolated common |
| 24  | Ciso | Yes | Isolated common |
| 25  | Ciso | Yes | Isolated common |

### Signals Present on Cable

The stage cable carries signals for one axis:
- **Encoder**: Differential quadrature (A/A-, B/B-, Z/Z-) + power (+5V, GND)
- **Limit switches**: 3 opto-interrupters (Forward, Home, Reverse)
  - These are powered from Viso/Ciso (isolated supply, 5-30V)
  - Output goes to the optically isolated sinking inputs on the UMI
  - The opto-interrupters need +V supply and ground, and have a digital output
  - If open-collector output: Viso -> pull-up -> signal input pin, output sinks to Ciso
  - If sourcing (PNP-style): Viso powers sensor, output drives input pin, return to Ciso

### Populated Pins on DB-25 (from connector photos)

From the photos of the DB-25 male connector (stage/Pics/PXL_20260106_162751644.jpg
and PXL_20260106_163028589.jpg), the following pins have contacts populated.
Two gray cables enter the DB-25 shell.

**Top row (pins 1-13):**
- Pins 1, 2, 3, 4: populated (encoder signals + power)
- Pins 5, 6, 7, 8, 9: empty
- Pins 10, 11, 12, 13: populated (limits/home + Viso)

**Bottom row (pins 14-25):**
- Pins 14, 15, 16, 17: populated (encoder differential- + ground)
- Pins 18, 19, 20, 21: empty
- Pins 22, 23: populated (Ciso)
- Pins 24, 25: empty

#### Summary of Wired Pins

| DB-25 Pin | UMI-7774 Signal | Group |
|---|---|---|
| 1 | Encoder Phase A | Encoder (cable 1)  |
| 2 | Encoder Phase B | Encoder (cable 1)  |
| 3 | Encoder Index (Z) | Encoder (cable 1)  |
| 4 | +5V Output | Encoder (cable 1)  |
| 14 | Encoder Phase A- | Encoder (cable 1)  |
| 15 | Encoder Phase B- | Encoder (cable 1)  |
| 16 | Encoder Index- | Encoder (cable 1)  |
| 17 | Digital Ground | Encoder (cable 1)  |
| 10 | Forward Limit | Limits (cable 2) |
| 11 | Home Input | Limits (cable 2) |
| 12 | Reverse Limit | Limits (cable 2) |
| 13 | Viso (Output) | Limits (cable 2) |
| 22 | Ciso | Limits (cable 2) |
| 23 | Ciso | Limits (cable 2) |

Total: 14 pins populated, matching the ~14 wires visible in the shell.

**Cable 1 (encoder, 8 wires):** Differential A/B/Z quadrature encoder with +5V
power and ground.

**Cable 2 (limits, 6 wires):** Three opto-interrupter signals (fwd/home/rev)
powered by the UMI's isolated supply (Viso/Ciso). Two Ciso pins are used,
likely one shared return and one spare, or separate returns for sensor groups.

### MC508 SCSI Cable Wire Colors (20-pin MDR)

**WARNING:** This pinout of the cable assembly from pins to colors was from continuity test on a single cable (stage/Pics/PXL_20260106_162549339.jpg). It turns out that some of the cables used have some pairs swapped, and really *who knows* what's in these actual cables. The pair swaps cause are known to cause some of the steppers step/direction to be negated. **Really all of the cables should be rebuilt from quality flying lead cables with documented pinout.**

| MDR Pin | Wire Color | MC508 Signal |
| --- | --- | --- |
| 1 | BLK | Enc A+ |
| 2 | BRN | /Enc A |
| 3 | RED | Enc B+ |
| 4 | ORN | /Enc B |
| 5 | YEL | +5V Enc |
| 6 | GRN | N/C |
| 7 | BLU | WDOG+ |
| 8 | PUR | WDOG- |
| 9 | GRY | Input A+ |
| 10 | WHT | Input Com |
| 11 | LTGRN | Enc Z+ |
| 12 | LTBLU | /Enc Z |
| 13 | PINK | Dir+  / Pulse+ |
| 14 | WHT/BLK | /Dir  / /Pulse |
| 15 | WHT/BRN | 0V Enc |
| 16 | WHT/RED | N/C |
| 17 | WHT/ORN | VOUT+ |
| 18 | WHT/YEL | VOUT- |
| 19 | WHT/GRN | N/C |
| 20 | WHT/BLU | Input B+ |

Note: Pins 13/14 are labeled "Dir+5" / "/Dir+5" in the notes. On the ATYPE 43
(stepper) port these are Pulse+/Pulse- (pins 1-2) or Dir+/Dir- (pins 3-4)
depending on configuration. On the ATYPE 76 (encoder) port, pins 13/14 don't
exist — the encoder port uses pins 1-4 for encoder A/B.

## MC508 Input Compatibility

### Encoder Signals — Compatible

The encoder outputs (RS-422 differential, 5V) connect directly to the MC508
flex axis encoder inputs. The MC508 encoder inputs accept differential RS-422
signals and provide +5V encoder power (100mA max per port). No adaptation needed.

### Limit Switch Signals — NOT Compatible

**Problem:** The opto-interrupter limit switches are sourcing (PNP) type, powered
from 5V (Viso on the UMI-7774). The MC508 digital inputs are ALL 24V
opto-isolated with a 6.8kΩ series resistor.

At 5V input: (5V - 1.2V) / 6.8kΩ ≈ 0.56 mA — far too low to turn on the
opto-isolator (needs ~3 mA, requiring ~21.6V minimum).

**The 5V opto-interrupter outputs cannot directly drive MC508 inputs.**

### Solution: MIC2981 High-Side Source Driver

Use a MIC2981/82YN (or equivalent UDN2981-compatible) 8-channel high-side
source driver to interface the 5V opto-interrupter outputs to the MC508 24V
PNP inputs. The MIC2981 has 8 channels with integrated input resistors, so
it can be driven directly from 5V logic. Each channel sources up to 500mA
from the Vs supply (far more than needed). The MC508 PNP inputs expect to
be driven high; the MIC2981 sources 24V to the input pin, and current flows
through the internal 6.8kΩ + opto-isolator to Input Com (0V).

**Circuit per limit switch:**
- Opto-interrupter 5V output → MIC2981 input
- MIC2981 output sources +24V → MC508 digital input pin
- MC508 Input Com tied to 0V (24V return)
- Current path: +24V → MIC2981 → input pin → internal opto + 6.8kΩ → Input Com → 0V
- MIC2981 Vs = +24V (same supply as MC508)
- MIC2981 GND = 0V (shared with MC508)

One MIC2981 handles all limit switches for all 3 axes (6 channels used of 8).

## MC508 Flex Axis Connector Pinout (20-pin MDR)

### ATYPE 43 — Stepper Pulse+Direction Output (P849 with axis N+8)

| Pin | Signal | Notes |
|-----|---|---|
| 1 | Pulse(N)+ | Differential step output, axis N |
| 2 | /Pulse(N) | |
| 3 | Dir(N)+ | Differential direction, axis N |
| 4 | /Dir(N) | |
| 5 | +5V | Encoder power (100mA max) |
| 7 | WDOG+ | Watchdog SSR (24V/100mA max, ~25Ω)  |
| 8 | WDOG- | |
| 9 | Input 16+n*2 | Digital input (24V, PNP) |
| 10  | Input Com | Input common |
| 11  | Pulse(N+8)+ | Differential step output, axis N+8  |
| 12  | /Pulse(N+8) | |
| 13  | Dir(N+8)+ | Differential direction, axis N+8 |
| 14  | /Dir(N+8) | |
| 15  | 0V | Digital ground |
| 17  | VOUT+ | Analog servo output (±10V DAC) |
| 18  | VOUT- | NOT a 24V power supply |
| 20  | Input 17+n*2 | Digital input (24V, PNP) |

Note: On P849, pins 11-14 carry axis N+8 pulse/direction instead of
enable/̅enable. The WDOG relay (pins 7/8) serves as the enable mechanism.

### ATYPE 76 — Encoder Input

| Pin | Signal | Notes |
|-----|---|---|
| 1 | Encoder A+ | Differential quadrature |
| 2 | /Encoder A | |
| 3 | Encoder B+ | Differential quadrature |
| 4 | /Encoder B | |
| 5 | +5V | Encoder power (100mA max) |
| 9 | Input 16+n*2 | Digital input (24V, PNP) |
| 11  | Encoder Z+ | Index pulse |
| 12  | /Encoder Z | |
| 15  | 0V | Digital ground |
| 20  | Input 17+n*2 | Digital input (24V, PNP) |

The 2 digital inputs per ATYPE 76 port are sufficient — only forward and
reverse limits are needed (home input is not used).

## Signals to Connect (per axis)

| DB-25 Pin | UMI-7774 Signal  | MC508 Destination | Notes |
|---|---|---|---|
| 1 | Encoder A+ | ATYPE 76 port pin 1 (Enc A+)  | Direct |
| 14 | Encoder A- | ATYPE 76 port pin 2 (/Enc A)  | Direct |
| 2 | Encoder B+ | ATYPE 76 port pin 3 (Enc B+)  | Direct |
| 15 | Encoder B- | ATYPE 76 port pin 4 (/Enc B)  | Direct |
| 3 | Encoder Z+ | ATYPE 76 port pin 11 (Enc Z+) | Direct |
| 16 | Encoder Z- | ATYPE 76 port pin 12 (/Enc Z) | Direct |
| 4 | +5V | ATYPE 76 port pin 5 (+5V) | Encoder power from MC508 |
| 17 | Digital Ground | ATYPE 76 port pin 15 (0V) | Encoder ground |
| 10 | Pos Limit | MIC2981 in → out to input pin 9 | Via high-side driver |
| 12 | Neg Limit | MIC2981 in → out to input pin 20  | Via high-side driver |
| 13 | Viso | External 5V supply | Opto-interrupter power |
| 22, 23 | Ciso | External 5V ground | Opto-interrupter return |
| 11 | Home Input | Not connected | Not used |

### Power Supplies

- **Encoders**: Powered from MC508 +5V on each ATYPE 76 port (pin 5, 100mA max).
  Encoder ground returns to MC508 0V (pin 15). Using the MC508's own encoder
  power avoids common-mode noise on the differential signals.
- **Opto-interrupters (limit switches)**: Powered from existing external 5V supply
  (previously used for UMI-7774 Viso). Ground shared with MIC2981 GND and MC508 0V.

## Adapter Wirelist (per axis)

DB-25 (stage cable) → MC508 SCSI cable, via adapter. Encoder port (ATYPE 76).

| DB-25 Pin | Signal | MC508 MDR Pin | SCSI Wire | Notes |
|---|---|---|---|---|
| 1 | Enc A+ | 1 | BLK | Direct |
| 14 | Enc A- | 2 | BRN | Direct |
| 2 | Enc B+ | 3 | RED | Direct |
| 15 | Enc B- | 4 | ORN | Direct |
| 3 | Enc Z+ | 11 | LTGRN | Direct |
| 16 | Enc Z- | 12 | LTBLU | Direct |
| 4 | +5V | 5 | YEL | MC508 encoder power |
| 17 | Dig Gnd | 15 | WHT/BRN | Encoder ground |
| 10 | Fwd Limit | — | — | To MIC2981 input |
| 12 | Rev Limit | — | — | To MIC2981 input |
| 13 | Viso | — | — | To external 5V supply  |
| 22, 23 | Ciso | — | — | To external 5V ground  |
| 11 | Home | — | — | Not connected |

MIC2981 outputs connect to MC508 SCSI cable:

| MIC2981 Out  | MC508 MDR Pin | SCSI Wire | MC508 Input |
|---|---|---|---|
| Fwd Limit | 9 | GRY | Input 16+n*2  |
| Rev Limit | 20 | WHT/BLU | Input 17+n*2  |

MC508 Input Com (pin 10, WHT) → 24V 0V return.

MIC2981 power:

| MIC2981 Pin | Signal | Connection |
|---|---|---|
| 9 (Vs) | +24V | External 24V supply + |
| 10 (GND) | 0V | External 24V supply 0V  |

### Encoder Adapter Wire Colors

These are the adapter wires (not from the SCSI cable) used in the encoder/limits
adapter. Colors chosen for visibility and to avoid confusion with SCSI cable colors.

| Wire ID | Function | Color | WireViz Code |
|---|---|---|---|
| LPOS | Pos limit → MIC2981 in | Blue | BU |
| LNEG | Neg limit → MIC2981 in | Violet  | VT |
| UPOS | MIC2981 out → MC508 Input A | Gray | GY |
| UNEG | MIC2981 out → MC508 Input B | Wht/Blu | WHBU |
| LPWR | Viso → Ext 5V (+) | Red | RD |
| LGND | Ciso → Ext 5V GND | Black | BK |
| ICOM | Input Com → 24V 0V | Black | BK |
| V24 | +24V → MIC2981 Vs | Yellow  | YE |
| UGND | MIC2981 GND → 24V 0V | Black | BK |

## Stepper Port Wirelist

**One stepper per ATYPE 43 port** (the primary axis, pins 1–4). Four stepper
ports are used: 4=X, 5=Y, 6=Z, 7=Rz. Each port drives one KL-4030 driver.

> **History:** the original design put two steppers per connector using the
> P849 N+8 secondary output (pins 11–14), to use only ports 4 and 5. That did
> not work — the primary ATYPE-43 enable output occupies pins 11/12, so the
> N+8 axis emitted no pulses. We moved to one stepper per port (ports 4–7).
> See Configuration.md "Axes" for the full explanation. The N+8 pin functions
> are kept in the connector pinout table above for reference only.

### Single-Ended Connection

The MC508 pulse/direction outputs are RS-422 differential. The KL-4030 inputs
are opto-isolated with both LED terminals accessible. We use single-ended
connection: only the + output from each RS-422 pair connects to the driver's
PUL+/DIR+, and the driver's PUL-/DIR- ties to MC508 0V (pin 15, signal ground).

This avoids reverse-biasing the opto LED (~5V reverse) when the RS-422 output
is in the low state. The complementary /Pulse and /Dir outputs are left
unconnected.

### Per port: primary axis (pins 1, 3) → KL-4030 driver

| MC508 MDR Pin | SCSI Wire | MC508 Signal | KL-4030 Pin | Notes |
|---|---|---|---|---|
| 1 | BLK | Pulse+ | PUL+ | Signal |
| 15 | WHT/BRN | 0V | PUL- | Ground reference |
| 3 | RED | Dir+ | DIR+ | Signal |
| 15 | WHT/BRN | 0V | DIR- | Ground reference |

Pins 2, 4 (/Pulse, /Dir) not connected. Pins 11–14 (N+8) not used.

> **⚠ Cable wiring uncertain.** The SCSI-wire colour column above is the
> *intended* mapping, but continuity checks during bring-up found differential
> pairs swapped inside some connectors (e.g. on X, "RED" actually lands on
> pin 4 = /Dir, not pin 3 = Dir+; on Rz it matches). The practical effect is
> that Step/Dir *polarity* differs by axis (X/Y vs Z/Rz idle-inverted), which
> is cosmetic for the stepper, and that **encoder sign** differs by axis — Rz
> ended up inverted relative to its stepper and is corrected in software
> (`enc_sign[]` in STARTUP.BAS). Pin 15 (0V, WHT/BRN) is correct on all axes.
> Treat the colour codes as nominal; the wirelist is correct by *pin function*,
> not necessarily by the colour found in a given physical cable. See
> Configuration.md "Counts and Units" cable note. If cables are rebuilt,
> re-verify pair orientation per axis.

## Enable and E-Stop Wiring

### Stepper Driver Enable

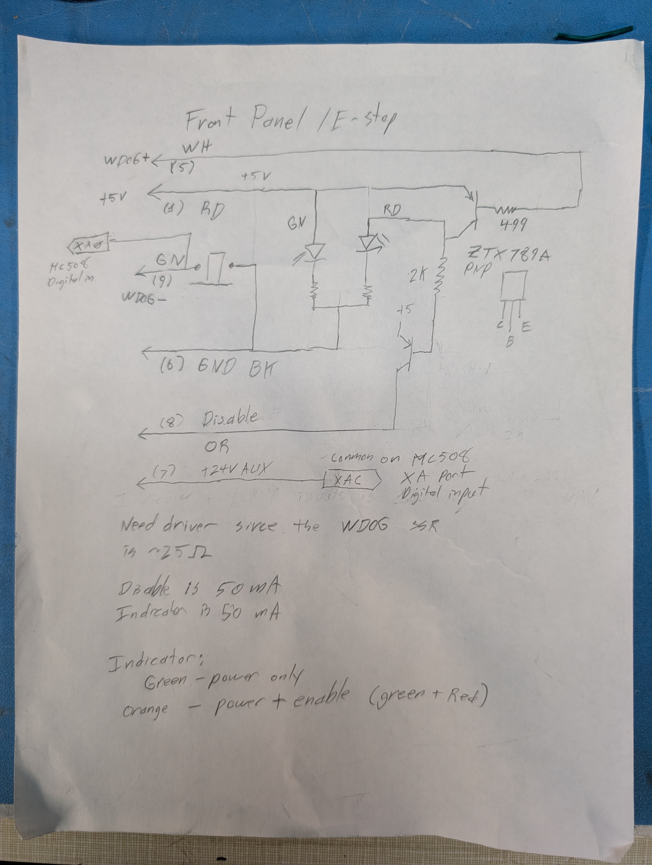
[picture p130: stage/Pics/front_panel_schematic.jpg]
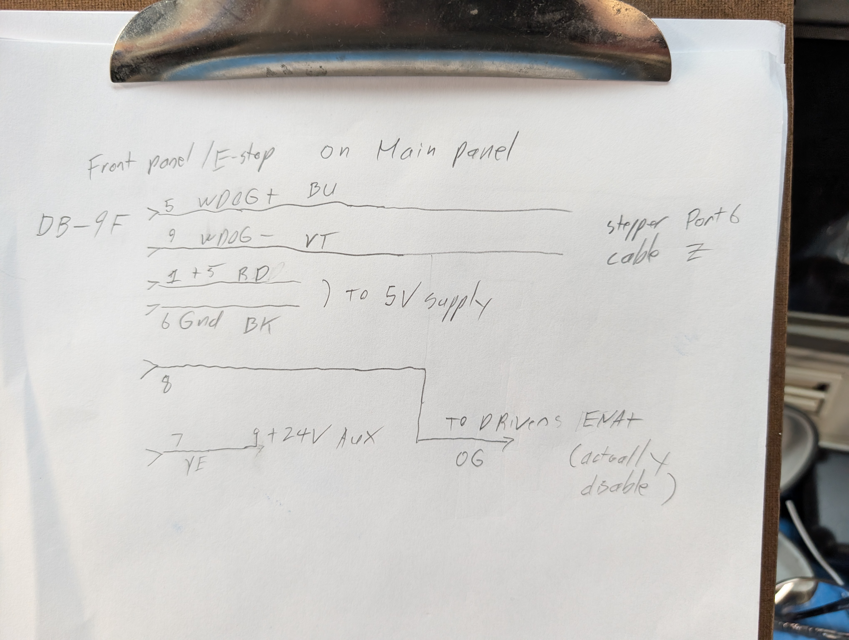
[picture p131: stage/Pics/front_panel_conn_main_panel_schematic.jpg]
The KL-4030 enable input (ENA+/ENA-) is an opto-isolator. There is some enable logic on the front panel, see . This is connected to the main panel by a DB-9 connector, see . The WDOG relay in the MC508 port 6 (Z axis stepper) cable is used to gate the driver enable for all drivers. Per-axis AXIS_ENABLE is not used.

**Circuit (per stepper port, one driver per port):**

- Note that the ENA input is actually a *disable*. It must be low to enable the driver. No current-limiting resistors needed — KL-4030 ENA opto inputs are designed
  for 5V direct drive (internal current limiting).
- KL-4030 ENA opto is isolated — ENA- returns to Ext 5V GND, not to MC508 0V.
  MC508 0V (pin 15, WHT/BRN) only ties to driver PUL-/DIR- (step/dir ground reference).

### E-Stop Software Feedback

E-stop is wired to MC508 digital **input 0 (terminal XA0)** so software can
detect the E-stop state (homing aborts on it; LabVIEW reads it). Reads ON when
released, OFF when pressed — independent of the WDOG relay. The hardwired
circuit above is what actually guarantees safety; this input is for status and
clean recovery. See Configuration.md.

### Stepper Cable Wires Used

Only a few wires of each stepper SCSI cable are used. Step/Dir + 0V go to the
driver; the enable is generated on the front panel (not per-port) and so is
**not** in the stepper cables — except the WDOG relay, which is carried to the
front panel on the **port 6 (Z)** cable only.

| SCSI Pin | Color (nominal) | Signal  | Used for |
|---|---|---|---|
| 1 | BK | Pulse+  | → Driver PUL+ |
| 3 | RD | Dir+ | → Driver DIR+ |
| 15 | WH/BR | 0V | → Driver PUL-/DIR- (gnd ref) |
| 7 | BU | WDOG+ | → front panel (port 6 cable only)|
| 8 | VT | WDOG- | → front panel (port 6 cable only)|

Colours are nominal — see the cable-uncertainty note above (and the SCSI
colour-table WARNING). The driver enable arrives from the front panel as a
shared bus: **OG = ENA+ (active-low disable), BK = ENA- (system ground)**.

## Wiring Diagrams (WireViz)

WireViz YAML definitions for the two adapter cables:

- **`wiring_encoder.yml`** — Encoder/limits adapter (DB-25 → MC508 encoder port + level shift)
- **`wiring_stepper.yml`** — One stepper port → one KL-4030 driver, with the
  shared front-panel enable bus shown as a dummy connector. The front-panel
  E-stop/enable logic itself is hand-drawn in
  `Pics/front_panel_schematic.jpg` and `Pics/front_panel_conn_main_panel_schematic.jpg`
  (not reproduced in WireViz).

Run `gen_wiring.bat` to regenerate diagrams (SVG + PNG + BOM).

**This document (stage_wiring.md) is the definitive wiring reference.**
The YAML files are rendering inputs for WireViz only — they should match
the wirelists here but contain no additional design rationale.
