robmacl/ilemt_cal_hw/stage/TrioDocumentation/MotionPerfect/CommunicationsSetup_files/image003.png

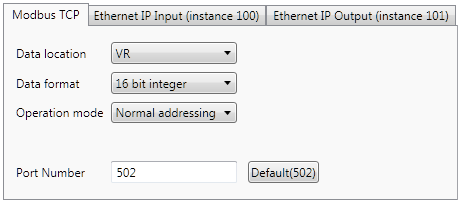
stage/TrioDocumentation/MotionPerfect/CommunicationsSetup_files/image003.png
