robmacl/ilemt_cal_hw/stage/TrioDocumentation/MotionPerfect/CommunicationsSetup_files/image005.png

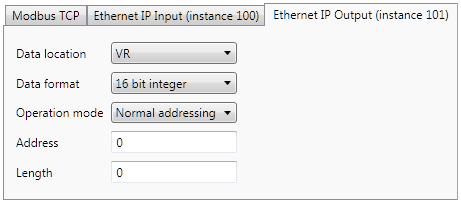
stage/TrioDocumentation/MotionPerfect/CommunicationsSetup_files/image005.png
