robmacl/ilemt_cal_hw/stage/TrioDocumentation/MotionPerfect/CommunicationsSetup_files/image009.png

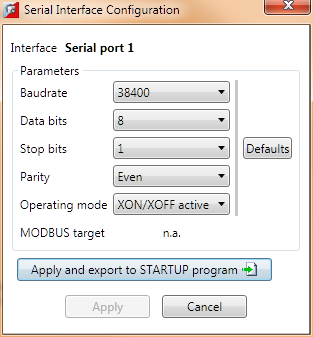
stage/TrioDocumentation/MotionPerfect/CommunicationsSetup_files/image009.png
