robmacl/ilemt_cal_hw/stage/TrioDocumentation/MotionPerfect/EtherCAT-Drive-BasicSetup_files/image010.png

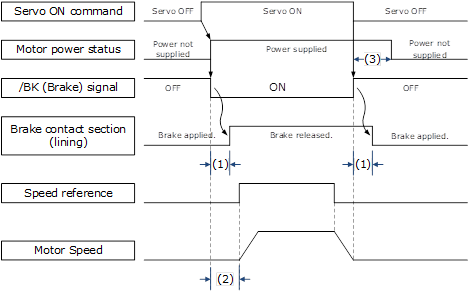
stage/TrioDocumentation/MotionPerfect/EtherCAT-Drive-BasicSetup_files/image010.png
