robmacl/ilemt_cal_hw/stage/TrioDocumentation/MotionPerfect/EtherCAT-Drive-BasicSetup_files/image012.png

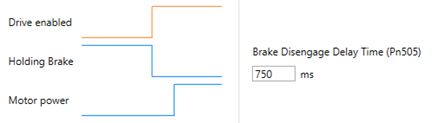
stage/TrioDocumentation/MotionPerfect/EtherCAT-Drive-BasicSetup_files/image012.png
