robmacl/ilemt_cal_hw/stage/TrioDocumentation/MotionPerfect/EtherCAT-Drive-BasicSetup_files/image014.png

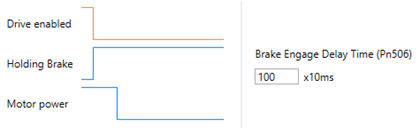
stage/TrioDocumentation/MotionPerfect/EtherCAT-Drive-BasicSetup_files/image014.png
