robmacl/ilemt_cal_hw/stage/TrioDocumentation/MotionPerfect/EtherCAT-Drive-ManualTuning_files/image003.png

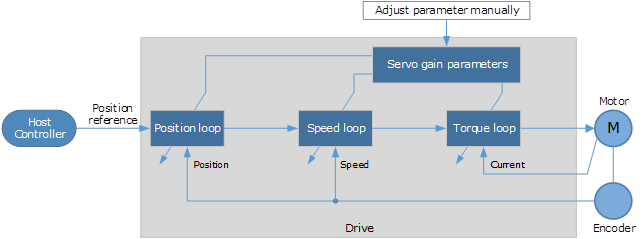
stage/TrioDocumentation/MotionPerfect/EtherCAT-Drive-ManualTuning_files/image003.png
