robmacl/ilemt_cal_hw/stage/TrioDocumentation/MotionPerfect/EtherCAT-Drive-OneParameterAutoTuning_files/image002.png

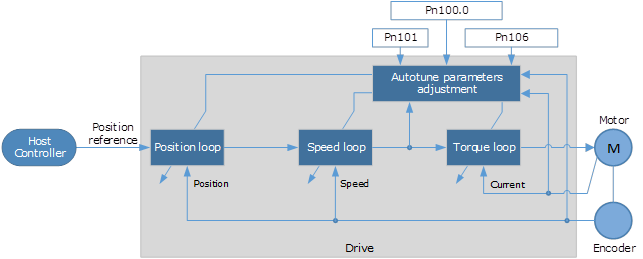
stage/TrioDocumentation/MotionPerfect/EtherCAT-Drive-OneParameterAutoTuning_files/image002.png
