robmacl/ilemt_cal_hw/stage/TrioDocumentation/MotionPerfect/EtherCAT-Drive-OneParameterAutoTuning_files/image004.png

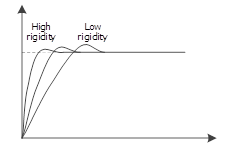
stage/TrioDocumentation/MotionPerfect/EtherCAT-Drive-OneParameterAutoTuning_files/image004.png
