robmacl/ilemt_cal_hw/stage/TrioDocumentation/MotionPerfect/EtherCAT-Drive-ParameterAutoTuning_files/image001.jpg

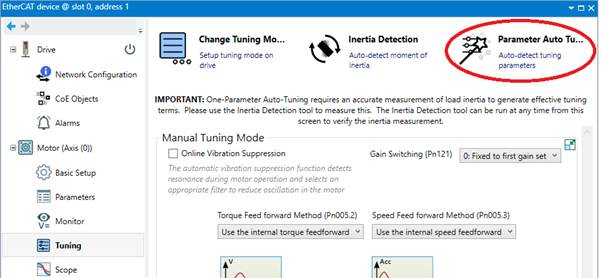
stage/TrioDocumentation/MotionPerfect/EtherCAT-Drive-ParameterAutoTuning_files/image001.jpg
