robmacl/ilemt_cal_hw/stage/TrioDocumentation/MotionPerfect/EtherCAT-Drive-ParameterAutoTuning_files/image002.png

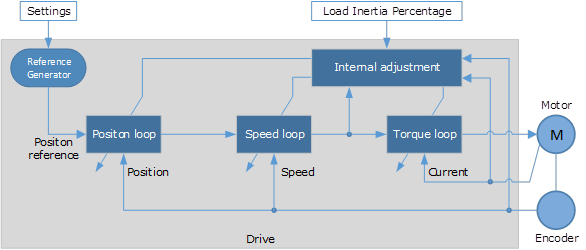
stage/TrioDocumentation/MotionPerfect/EtherCAT-Drive-ParameterAutoTuning_files/image002.png
