robmacl/ilemt_cal_hw/stage/TrioDocumentation/MotionPerfect/EtherCAT-Drive-SwitchTuningMode_files/image001.jpg

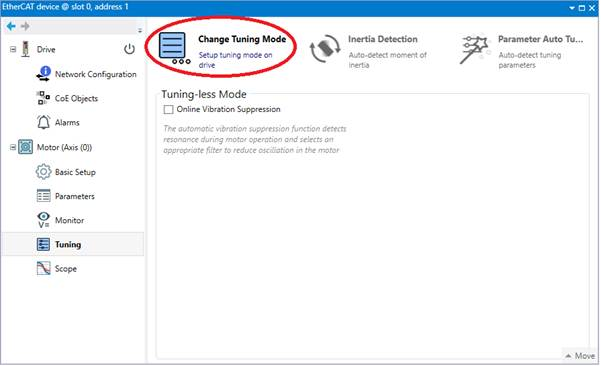
stage/TrioDocumentation/MotionPerfect/EtherCAT-Drive-SwitchTuningMode_files/image001.jpg
