robmacl/ilemt_cal_hw/stage/TrioDocumentation/MotionPerfect/EtherCAT-Drive-Tuning_files/image003.png

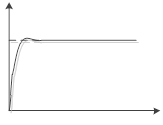
stage/TrioDocumentation/MotionPerfect/EtherCAT-Drive-Tuning_files/image003.png
