robmacl/ilemt_cal_hw/stage/TrioDocumentation/MotionPerfect/EtherCAT-Drive-Tuning_files/image008.png

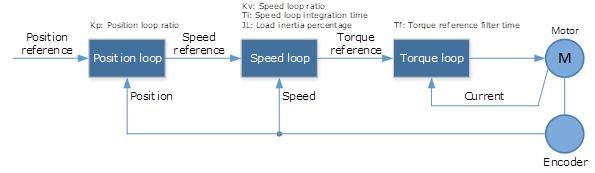
stage/TrioDocumentation/MotionPerfect/EtherCAT-Drive-Tuning_files/image008.png
