robmacl/ilemt_cal_hw/stage/TrioDocumentation/MotionPerfect/ProjectEncryption-GenerateValidationKeys_files/image002.jpg

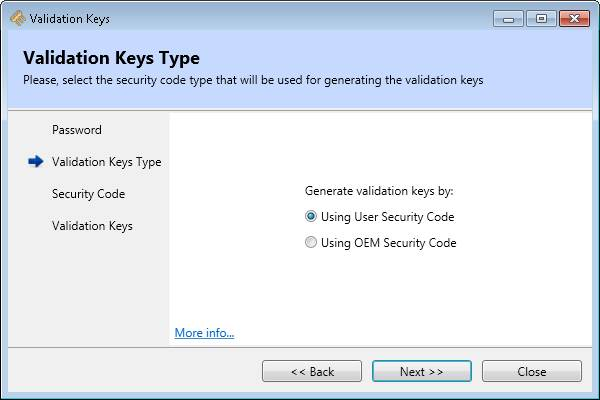
stage/TrioDocumentation/MotionPerfect/ProjectEncryption-GenerateValidationKeys_files/image002.jpg
