robmacl/ilemt_cal_hw/stage/TrioDocumentation/MotionPerfect/ProjectEncryption-GenerateValidationKeys_files/image003.jpg

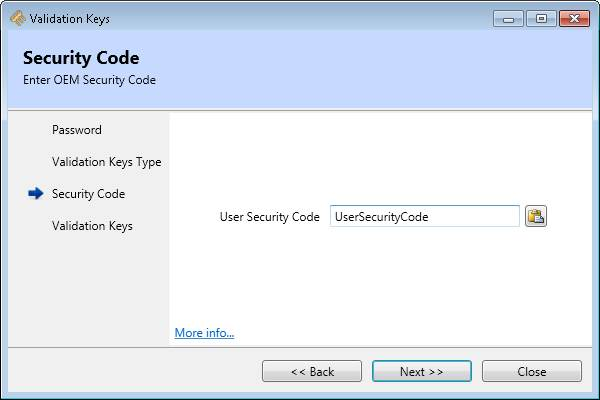
stage/TrioDocumentation/MotionPerfect/ProjectEncryption-GenerateValidationKeys_files/image003.jpg
