robmacl/ilemt_cal_hw/stage/TrioDocumentation/MotionPerfect/ProjectEncryption-GenerateValidationKeys_files/image004.jpg

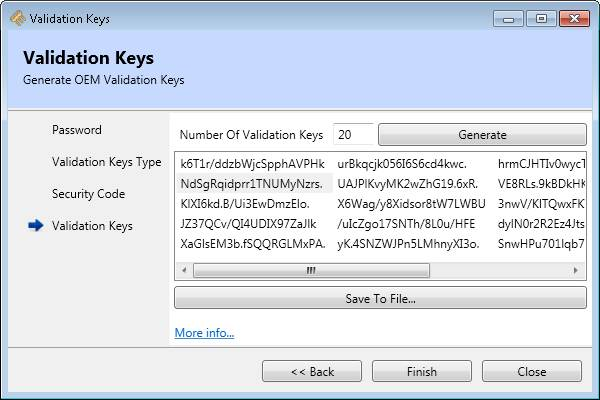
stage/TrioDocumentation/MotionPerfect/ProjectEncryption-GenerateValidationKeys_files/image004.jpg
