robmacl/ilemt_cal_hw/stage/trio_cmd.py

"""Send commands to MC508 via telnet and print responses.

Usage:
    python trio_cmd.py [options] "CMD1" "CMD2" ...

Options:
    --debug     Show raw hex data
    --port N    Use port N (default 23)
    --wait N    Wait N seconds after connect (default 2)

Examples:
    python trio_cmd.py "PRINT 1+1"
    python trio_cmd.py "?ATYPE AXIS(2)" "?MPOS AXIS(2)"
    python trio_cmd.py --debug "?ATYPE"
"""
import socket
import sys
import time

HOST = '192.168.1.250' # factory default is 192.168.0.250
PORT = 23
TIMEOUT = 5


def recv_all(sock, timeout=1.0):
    """Read all available data from socket."""
    sock.settimeout(timeout)
    data = b''
    deadline = time.time() + timeout
    while time.time() < deadline:
        try:
            d = sock.recv(4096)
            if not d:
                break
            data += d
        except socket.timeout:
            break
    return data


def recv_until_prompt(sock, timeout=3.0):
    """Read until we see the >> prompt, which signals the response is complete."""
    sock.settimeout(timeout)
    data = b''
    deadline = time.time() + timeout
    while time.time() < deadline:
        try:
            d = sock.recv(4096)
            if not d:
                break
            data += d
            # Check for prompt after stripping telnet sequences
            clean = strip_telnet(data)
            if clean.rstrip().endswith(b'>>'):
                break
        except socket.timeout:
            break
    return data


def strip_telnet(data):
    """Strip telnet IAC negotiation sequences."""
    result = bytearray()
    i = 0
    while i < len(data):
        if data[i] == 0xFF and i + 1 < len(data):
            if data[i + 1] == 0xFF:
                result.append(0xFF)  # Escaped 0xFF
                i += 2
            elif i + 2 < len(data):
                i += 3  # IAC + cmd + option
            else:
                i += 2
        else:
            result.append(data[i])
            i += 1
    return bytes(result)


def negotiate_telnet(sock, raw_data):
    """Respond to telnet negotiation requests."""
    i = 0
    responses = bytearray()
    while i < len(raw_data):
        if raw_data[i] == 0xFF and i + 2 < len(raw_data):
            cmd = raw_data[i + 1]
            opt = raw_data[i + 2]
            if cmd == 0xFD:  # DO -> respond WILL
                responses.extend([0xFF, 0xFB, opt])
            elif cmd == 0xFB:  # WILL -> respond DO
                responses.extend([0xFF, 0xFD, opt])
            i += 3
        else:
            i += 1
    if responses:
        sock.sendall(bytes(responses))


def send_cmd(sock, cmd, debug=False):
    """Send a command and return the response text."""
    recv_all(sock, timeout=0.05)  # flush
    sock.sendall((cmd + '\r').encode())
    raw = recv_until_prompt(sock, timeout=3.0)
    if debug:
        print(f"   Raw ({len(raw)} bytes): {raw[:200].hex()}")
        if raw:
            print(f"   Repr: {repr(raw[:200])}")
    clean = strip_telnet(raw)
    text = clean.decode(errors='replace')
    # Remove echo of our command, >> prompts, and blank lines
    lines = text.split('\r\n') if '\r\n' in text else text.split('\n')
    filtered = []
    for l in lines:
        s = l.strip()
        if not s:
            continue
        if s == '>>':
            continue
        if s.startswith(cmd.strip()[:20]):
            continue
        filtered.append(l.rstrip())
    return '\n'.join(filtered).strip()


def connect(host=HOST, port=PORT, wait=None, debug=False):
    """Connect to the MC508 and return the socket (after telnet negotiation)."""
    s = socket.socket(socket.AF_INET, socket.SOCK_STREAM)
    s.settimeout(TIMEOUT)
    s.connect((host, port))

    # Wait for banner and telnet negotiation
    banner_raw = recv_until_prompt(s, timeout=wait or 5.0)

    if debug:
        print(f"Initial data ({len(banner_raw)} bytes): {banner_raw[:200].hex()}")

    if banner_raw:
        negotiate_telnet(s, banner_raw)
        recv_all(s, timeout=0.1)  # flush negotiation response

        banner = strip_telnet(banner_raw)
        if banner.strip():
            print(f"Banner: {banner.decode(errors='replace').strip()}")

    return s


def main():
    args = sys.argv[1:]
    debug = '--debug' in args
    if debug:
        args.remove('--debug')

    port = PORT
    if '--port' in args:
        idx = args.index('--port')
        port = int(args[idx + 1])
        args = args[:idx] + args[idx + 2:]

    wait_time = 2
    if '--wait' in args:
        idx = args.index('--wait')
        wait_time = float(args[idx + 1])
        args = args[:idx] + args[idx + 2:]

    commands = args if args else ['PRINT "Hello MC508"']

    s = None
    try:
        s = connect(HOST, port, wait_time, debug)
        print(f"Connected to {HOST}:{port}")

        for cmd in commands:
            print(f"\n>> {cmd}")
            result = send_cmd(s, cmd, debug=debug)
            if result:
                print(result)
            else:
                print("(no response)")

    except ConnectionRefusedError:
        # Host reachable but nothing is listening on the telnet port.
        print(f"Connection refused by {HOST}:{port}. The MC508 is reachable "
              "but not accepting telnet there - is it the right port?")
        return 1
    except (socket.timeout, TimeoutError, OSError) as e:
        # Timeout / no route / network unreachable - the usual "it's offline".
        print(f"Could not reach the MC508 at {HOST}:{port} ({type(e).__name__}).")
        print("Check that the controller is powered on, on the network, and at "
              f"the expected IP (currently HOST={HOST}).")
        return 1
    except Exception as e:
        print(f"Error: {type(e).__name__}: {e}")
        return 1
    finally:
        if s is not None:
            s.close()
    return 0


if __name__ == '__main__':
    sys.exit(main())
