robmacl/ilemt_cal_hw/(commit log)

2026-01-27 Initial commit: Hardware documentation and design files
    - Motion controller (Trio MC508) documentation
    - Stage hardware PDFs
    - Optical sensor mounting designs (SolidWorks)
    - Reference datasheets for components
    [93600A208_316 Stainless Steel Dowel Pin.SLDPRT, LK-G150_152_155_157_2.sldprt, X_bracket.SLDPRT, YZ_bracket.SLDPRT, cylinder_target.SLDPRT, sensor_mount.SLDASM]
2026-01-27 Add project documentation (claude.md)
    - Project overview and scope
    - Hardware component descriptions
    - Technical notes on MC508 flexible axis configuration
    - Homing and registration documentation
    - Current task: cable wirelist creation
    - Repository structure and references
2026-02-02 First cut at a wiring list for MC508 hookup.
    [wiring_encoder.bom.tsv, wiring_stepper.bom.tsv]
2026-02-03 Update wiring diagrams and documentation.
    - Fix VOUT description (analog servo output, not 24V supply)
    - Clarify ULN2003A level shift circuit connections
    - Update stepper and encoder wiring diagrams
    - Minor project description update
    [wiring_encoder.bom.tsv, wiring_stepper.bom.tsv]
2026-02-03 Add encoder wiring diagram source YAML.
2026-02-03 Change limit switch level shifter from ULN2003A sink to MIC2981 high-side driver
    The MC508 digital inputs are PNP (expect high-side drive). Using a MIC2981
    high-side source driver instead of ULN2003A sink driver. Added 24V supply
    connection for the MIC2981 Vs pin.
    [wiring_encoder.bom.tsv]
2026-02-03 Merge documentation from clever-leakey session.
    - Add KL-4030 stepper driver info
    - Update P849 pin assignments (dual-axis ports)
    - Add Key Hardware Findings section (24V inputs, VOUT, WDOG, etc.)
    - Add WireViz/Graphviz tool documentation
    - Update checklists and next steps
    - Update repo structure with wiring files
2026-02-06 Update documentation to reflect MIC2981 high-side driver
    Replace all ULN2003A references with MIC2981 in CLAUDE.md and stage_wiring.md.
    Updated stepper wiring for single-ended connection with ground reference.
2026-02-07 Fix wire colors and add adapter wire color tables
    - Use quoted hex color "#90EE90" for light green (LTGRN)
    - Fix WHBU stripe order (white base, blue stripe)
    - Add Encoder Adapter Wire Colors table to stage_wiring.md
    - Add Stepper Adapter Wire Colors table to stage_wiring.md
    - Markdown is now definitive source for adapter wire colors
    [wiring_encoder.yml, wiring_stepper.yml]
2026-02-07 Add tie points to show SCSI cable wire colors at MC508 connectors
    - MC508 Input Com (pin 10, WHT) now shows white SCSI wire to tie point
    - MC508 0V (pin 15, WHT/BRN) now shows white/brown SCSI wire to tie point
    - MC508 WDOG- (pin 8, PUR) now shows purple SCSI wire to tie point
    - Adapter wires (black, orange) fan out from tie points to destinations
    - Makes SCSI cable colors visible in diagrams
    [wiring_encoder.bom.tsv, wiring_stepper.bom.tsv]
2026-02-07 Change +24V wire color to yellow to distinguish from +5V
2026-02-07 Change LREV wire color to violet to distinguish from +5V power wires
2026-02-11 Fix WDOG+ wire color to blue (SCSI pin 7)
    [wiring_stepper.yml]
2026-02-21 Fix wiring: rename Fwd/Rev to Pos/Neg, remove erroneous 0V-to-5V tie
    - Rename limit switch wires LFWD/LREV → LPOS/LNEG, UFWD/UREV → UPOS/UNEG
    - Update MIC2981 pin labels to Pos/Neg
    - Remove SGND: KL-4030 ENA opto is isolated, so ENA- returns to Ext 5V GND
    directly; MC508 0V (pin 15) only serves as step/dir ground reference
    [wiring_encoder.bom.tsv, wiring_stepper.bom.tsv]
2026-02-21 MIC2981: remove DIP-18 type and real pin numbers, use sequential 1-6
    The chip is shared across all four encoder cables so DIP pin numbers
    are misleading. Use generic type and sequential pin numbering.
    [wiring_encoder.bom.tsv]
2026-02-22 Back panel design
    [back_panel.SLDPRT]
2026-03-15 Z axis bring-up: Python tooling, test script, and configuration docs
    Add trio_cmd.py telnet utility and trio_upload_config.py for MC_CONFIG.bas
    upload. Add z_axis_test.py interactive bring-up script with test move,
    encoder ratio verification, and limit-switch homing. Document axis
    configuration, UNITS, direction conventions, and MC508 P849 quirks
    discovered during testing (INVERT_STEP ineffective, x16 multiplier
    confirmed, DEFPOS for zeroing, program-only JOG commands).
2026-05-16 Start of CAD for sensor boom
    [5287T681_High-Strength Lightweight Carbon Fiber Tube.SLDPRT, RT-3-10.SLDPRT, boom_base.SLDPRT, boom_end.SLDPRT, sensor_boom.SLDASM, sensor_holder.SLDPRT]
2026-05-26 New pics of front panel schematics, updates to claude.md
2026-05-30 Consolidate stage docs: merge quirks into Configuration.md, dedupe claude.md
    - Merge MC508_quirks.md into stage/Configuration.md (config + quirks in one
    controller/software reference); delete MC508_quirks.md.
    - Reduce claude.md to an index: replace duplicated pin assignments, hardware
    findings, and the stale repo tree with pointers to the topic docs; add a
    project status line.
    - stage_wiring.md: add a Configuration.md cross-reference at the top and
    remove the stale Port Assignment section that contradicted the final axis map.
2026-05-31 Add MC508 init + simple homing (microstep units) and live monitor
    - MC_CONFIG.bas: ATYPE assignments for all four axes (enc 76 / stepper 43).
    - STARTUP.BAS: power-on init (microstep UNITS, motion params, limit inputs,
    WDOG) plus simple two-limit homing with both-limits self-test, midpoint
    zero, e-stop watch, and a VR-based status/fault interface for LabVIEW.
    - homing_monitor.py: telnet live dashboard (built on trio_cmd.py) that polls
    the status VRs and VRSTRING detail, and can issue HOME_REQ / clear faults.
    - Configuration.md: switch UNITS/motion params to microsteps with the
    mm/deg boundary conversion, document the closed-loop model, the simple
    homing procedure, and the full MC508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
    [MC_CONFIG.bas, STARTUP.BAS, homing_monitor.py]
2026-05-31 Set e-stop sense to input 0 (XA0), active-low-when-pressed
    E-stop is wired to digital input 0 (terminal XA0): reads ON when released,
    OFF when pressed, independent of WDOG. Fixed STARTUP.BAS (input number and
    flipped the three IN() tests to treat OFF as asserted) and updated the
    Configuration.md note from placeholder to the resolved fail-safe wiring.
    [STARTUP.BAS]
2026-06-01 Add --inputs no-motion limit/e-stop toggle view to homing_monitor
    A live IN() display for the e-stop (XA0) and all eight limit inputs, so each
    switch can be confirmed by hand before trusting a homing seek. Documented in
    the bring-up workflow.
2026-06-01 Speed up upload (prompt-based) and handle single-telnet-session limit
    - trio_upload_config.py: switch send_cmd from fixed 0.3s/line to prompt-based
    reception (reusing trio_cmd recv_until_prompt), so a 228-line insert takes a
    few seconds instead of ~70s; add insert progress counter.
    - homing_monitor.py: catch ConnectionError/OSError and explain the MC508
    one-telnet-session-at-a-time limit instead of dumping a traceback.
    - Configuration.md: document that the tools must run sequentially and that
    --run starts STARTUP (drives hold) but does not move until --home.
    [homing_monitor.py, trio_upload_config.py]
2026-06-01 Fix STARTUP compile error: drop comma-list DIM of scalars
    DIM cannot take a comma-separated list (only DIM name AS type), which
    failed compile at line 28 (AS expected). Scalars default to FLOAT and
    need no declaration, so the two DIM lines are simply removed.
    [STARTUP.BAS]
2026-06-01 Add --range readout; record validated Z homing result
    homing_monitor.py --range prints measured per-axis travel (microsteps), the
    encoder/stepper ratio (free correctness check, ~1.0), and the physical
    equivalent. Record the first Z homing validation in Configuration.md: enc/stp
    ratio 0.99997 over ~100.5 mm, confirming the x16 multiplier, UNITS, and
    encoder direction.
    [homing_monitor.py]
2026-06-01 Replace homing timeout guard with encoder stall detection
    The X seek hit a real TIMEOUT: at HOME_SPEED the 30s window only covered
    ~150mm, shorter than X's travel, so it ran out mid-seek (DPOS~=MPOS, both
    limits still reading away). Two fixes:
    - Stall detection: during a seek, compare stepper-axis DPOS against the
    shaft encoder MPOS (cross-axis; the stepper axis has no encoder of its own
    so FE is useless there). Divergence > ~400 microsteps means the motor is
    commanded but not following -- a dead/miswired limit, hardstop, or
    collision -- and aborts within ~1 tick with new FAULT code 8 (STALL),
    instead of grinding into a hardstop until a timeout.
    - Timeout raised to ~120s as a gene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
    [STARTUP.BAS, homing_monitor.py]
2026-06-03 Document N+8 pulse-output blocker and draft Trio support inquiry
    Root cause found for Y/Rz not moving: the primary ATYPE-43 axis drives its
    Enable(n) output on connector pins 11/12 -- the same pins the P849 secondary
    (n+8) axis needs for Pulse(n+8). Scope confirms pins 11/12 static-high, no
    pulses, while DPOS advances. X/Z (primary axes 4,5) are unaffected and work.
    AXIS_Z_OUTPUT=0 did not re-mux the pins.
    - trio_support_inquiry.md: writeup for Trio (hw/fw/FPGA versions, symptom,
    what we tried, specific questions, and the ports-6/7 fallback).
    - Configuration.md: blocker note in the Axes section with the fallback plan.
    No code change; X/Z homing remains validated.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
2026-06-04 Stepper per-port (4-7) config; per-axis cable-compensation; docs
    The P849 n+8 two-steppers-per-connector scheme did not work (primary ATYPE-43
    enable output occupies the same pins 11/12 the n+8 axis needs; high-density
    ATYPE 100 is global and dropped all steppers). Resolved by giving each stepper
    its own primary port: X=4 Y=5 Z=6 Rz=7, encoders unchanged on ports 0-3.
    Cabling is of uncertain/non-uniform internal wiring (continuity checks found
    swapped differential pairs in some connectors). Effects, all handled in
    software so each axis is self-consistent:
    - Step/Dir polarity differs by axis (cosmetic for steppers).
    - Encoder sign differs by axis -> per-axis enc_sign[] in STARTUP.BAS; Rz is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
    [MC_CONFIG.bas, STARTUP.BAS, wiring_stepper.yml]
2026-06-04 Regenerate wiring diagrams for one-stepper-per-port
    Installed wireviz + graphviz on this machine and rebuilt the diagrams to match
    the per-port stepper config. Fixes in wiring_stepper.yml: dropped the unused WD
    adapter cable (no WDOG fan-out with one driver per port; WDOG- SCSI wire goes
    straight to ENA+) and removed an ASCII "->" from a notes string that broke the
    Graphviz HTML label. stage_wiring.md wire-color table updated to match.
    Adds .png/.html artifacts alongside the existing .svg/.bom.tsv.
    [wiring_stepper.bom.tsv]
2026-06-04 gen_wiring.bat: add this machine's Python Scripts path
    Add the regular Python 3.12 per-user Scripts dir (where wireviz installs on
    this machine) alongside the original Microsoft Store 3.11 path, so the script
    finds wireviz on both setups. Verified it runs self-contained.
2026-06-04 Stepper wiring: front-panel enable bus; fix adapter-wire table
    The driver enable is generated on the front panel (E-stop + WDOG-buffered PNP,
    see Pics/front_panel_schematic.jpg), not per-port, and distributed to all
    drivers as a shared bus (OG=ENA+ active-low disable, BK=ENA- system ground).
    The MC508 WDOG relay reaches the front panel only via the port-6 (Z) cable.
    - wiring_stepper.yml: drop the bogus per-port E-stop/WDOG circuit; show the
    shared enable as an FP_ENABLE dummy connector. Regenerated SVG/BOM.
    - stage_wiring.md: rewrite the garbled adapter-wire-colors table as a concise
    "wires used" table (RD/BK/WH-BR per port; BU/VT to front panel on port 6
    only); correct the enable nar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
    [wiring_stepper.bom.tsv]
2026-06-07 Add encoder Z-index datum to homing
    Home now refines the coarse limit/midpoint home with a fine, repeatable
    datum from the encoder index pulse. After reaching the midpoint, STARTUP.BAS
    arms REGIST(20,0,1,0,0) on the encoder axis (Z mark), creeps the stepper a
    fixed per-axis direction (seek_dir[], all +1), waits for MARK, and OFFPOSes
    both axes by negative REG_POS so the index reads zero. The capture is
    hardware-latched, so the math datum needs no move-back. Adds the
    midpoint-to-index offset VRs (IDX_OFF 128..131), an INDEX_NOT_FOUND fault (9),
    and a seek_index state (14).
    DATUM cannot be used here (stepper and encoder are on separate axes), so
    DATUM_IN is now unused (left only as a record o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
    [STARTUP.BAS, homing_monitor.py, index_test.py]
2026-06-12 Changed MC508 IP address to 192.168.1.250
    [wiring_encoder.bom.tsv, wiring_stepper.bom.tsv]
2026-06-22 Harden limit stop (FASTDEC) and auto-retry flash-write errors on upload
    STARTUP.BAS: raise FASTDEC to RUN_ACCEL*40 so a limit hit after homing
    stops abruptly (~10x less overshoot) instead of clunking the hard stop.
    FASTDEC only affects limit/CANCEL/RAPIDSTOP, so normal moves (DECEL) are
    unchanged.
    trio_upload_config.py: long uploads occasionally fail mid-insert with an
    "Error programming Flash" fault (transient flash-write error under
    sustained rapid inserts, not seen on short files). Auto-retry the whole
    upload a few times on this specific error; since each attempt deletes all
    lines before re-inserting, retries cannot leave duplicate/shifted lines.
    Deterministic errors still fail fast. Doc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
    [STARTUP.BAS, trio_upload_config.py]
2026-06-23 trio_cmd.py: clean error when the MC508 is unreachable
    A connect() failure left 's' unbound, so the finally block's s.close()
    raised UnboundLocalError and buried the real cause under a traceback.
    Guard the close (s = None up front, close only if set), map
    timeout/no-route/refused to clear "is it powered on / right IP?" messages,
    and return proper exit codes via sys.exit(main()).
    [trio_cmd.py]
2026-09-17 Pulled over documentation in stage/ from the Micron repo.
    [sensor_holder.SLDPRT]
2026-09-29 I think this is just a solidworks version change.
    [sensor_holder.SLDPRT]
